st0ff3r/trappe/til ugespejl/still stoffer 9.jpg

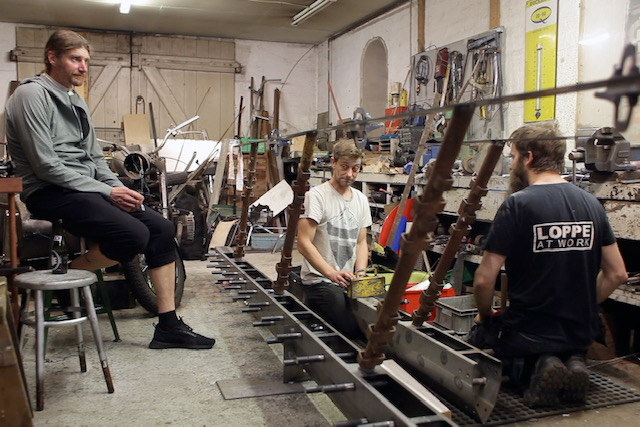
til ugespejl/still stoffer 9.jpg
