st0ff3r/trappe/til ugespejl/still stoffer 6.jpg

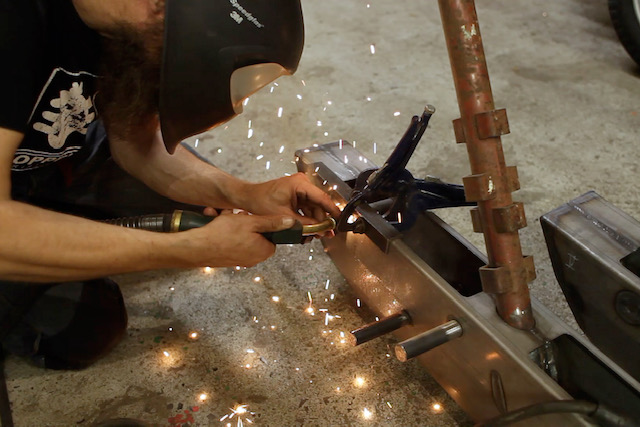
til ugespejl/still stoffer 6.jpg
