st0ff3r/trappe/skilt.rtf

Byggeår: 2020
Materiale: Stål, S355MC
Producent: stoffer@loppen.dk

https://github.com/st0ff3r/trappe

…skynd dig langsomt
