st0ff3r/trappe/projektoplæg.rtfd/TXT.rtf

Projektoplæg svendeprøve

1. Navn: Kristoffer Ek
2. Trappen er udviklet i samarbejde med Musikloppen.
3. Projektet er en trappe med have udført til Musikloppen. Vangerne fremstilles som rør med profil der giver plads til jord hvori der plantes efeu der vil gro op og dække rækværket udført i Ishøj-hegn. Dermed nyttiggøres vangerne til dobbelt formål. Innovativt idet der ikke findes lignende trapper. Den vil fremover tilføre en nødudgang et grønt miljø. Faktiske forhold er opmålt og tegninger fremstillede efter mål.
4. Skitsetegning
5. Sværhedsgradsskema
6. Svejseprocesser: 111, 141, 135/136
7. Trappen udføres i 3 mm stålplade til vanger, universal-stilladssøjler til balustre, håndfang af fladstål og trin af træ understøttet med rør der monteres i vangerne på stifter i vangerne. Vangernes ende udføres i 10 mm stål. Fødder ligeledes i 10 mm stål og gevindstang.
8. Maskiner og bearbejdsningsprocesser: CNC plasmaskæring, kantpresse, svejsning, savning, flammeskæring etc.
9. Stålforbrug
