st0ff3r/trappe/lasker.pdf

# lasker

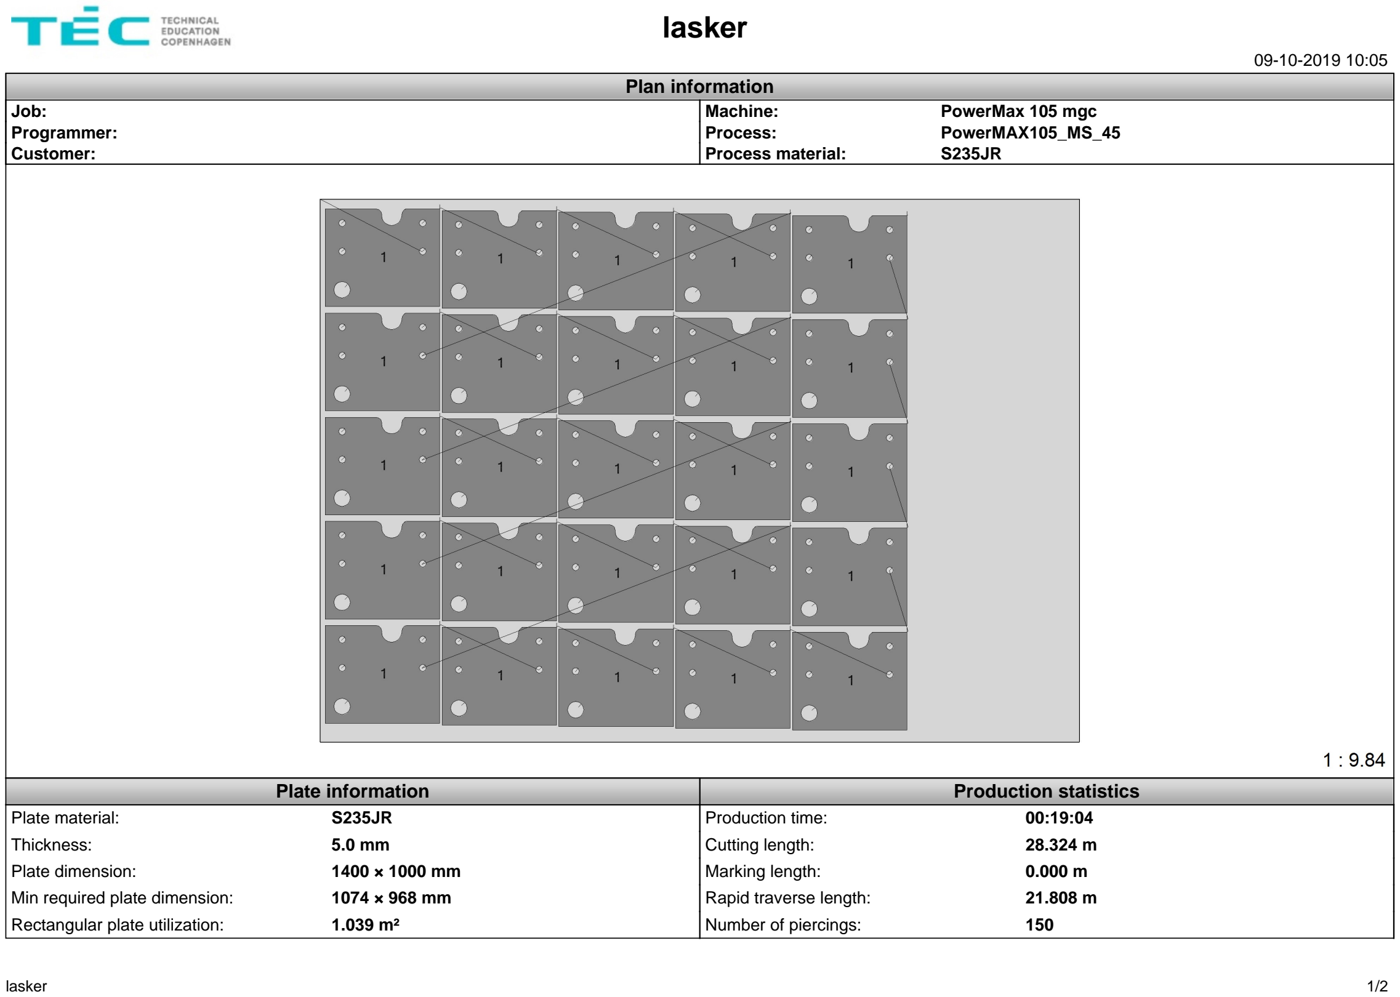
[picture p4: page 1]

09-10-2019 10:05
Plan information
Job: | Machine: | PowerMax 105 mgc
Programmer: | Process: | PowerMAX105_MS_45
Customer: | Process material: | S235JR
| Plate information | | Production statistics
Plate material: | S235JR | Production time: | 00:19:04
Thickness: | 5.0 mm | Cutting length: | 28.324 m
Plate dimension: | 1400 × 1000 mm | Marking length: | 0.000 m
Min required plate dimension: | 1074 × 968 mm | Rapid traverse length: | 21.808 m
Rectangular plate utilization: | 1.039 m² | Number of piercings: | 150
lasker | 1/2

Part ID | Part name | Quantity (nested) | Part size | Part weight | Cutting time
1 | laske | 25 | 211 × 180 mm | 1.403 kg | 00:00:43
lasker | 2/2
