st0ff3r/trappe/top- og bundvange-endeplader.pdf

# top- og bundvange-endeplader

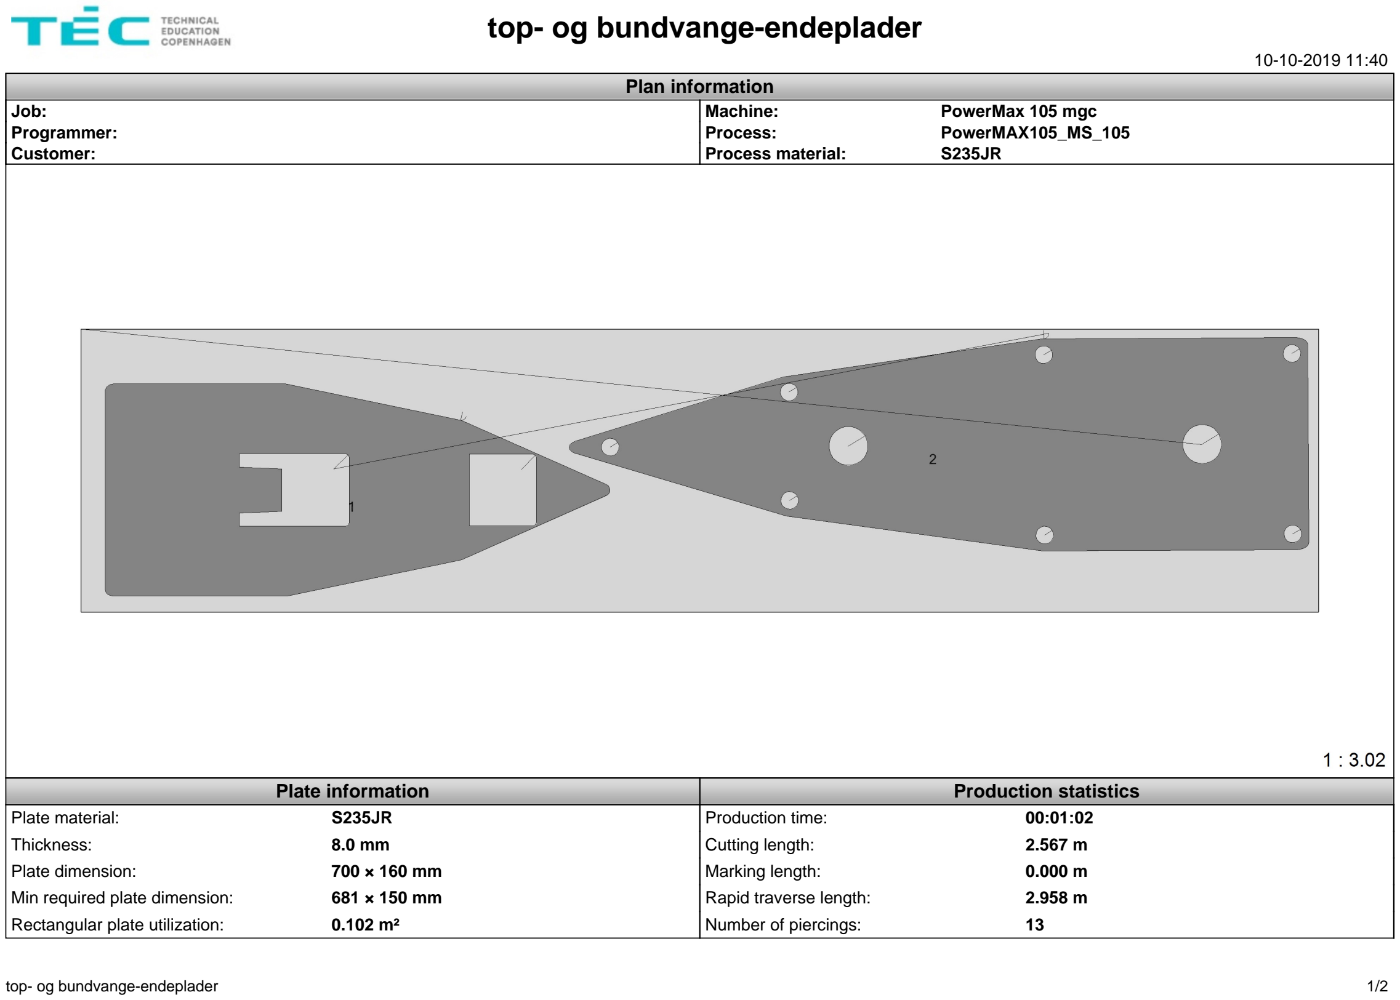
[picture p5: page 1]

10-10-2019 11:40
Plan information
Job: | Machine: | PowerMax 105 mgc
Programmer: | Process: | PowerMAX105_MS_105
Customer: | Process material: | S235JR
| Plate information | | Production statistics
Plate material: | S235JR | Production time: | 00:01:02
Thickness: | 8.0 mm | Cutting length: | 2.567 m
Plate dimension: | 700 × 160 mm | Marking length: | 0.000 m
Min required plate dimension: | 681 × 150 mm | Rapid traverse length: | 2.958 m
Rectangular plate utilization: | 0.102 m² | Number of piercings: | 13
top- og bundvange-endeplader | 1/2

Part ID | Part name | Quantity (nested) | Part size | Part weight | Cutting time
1 | top vange-endeplade | 1 | 120 × 285 mm | 1.391 kg | 00:00:25
2 | bund vange-endeplade | 1 | 422 × 139 mm | 2.277 kg | 00:00:30
top- og bundvange-endeplader | 2/2
