st0ff3r/trappe/vange 2.pdf

# vange 2

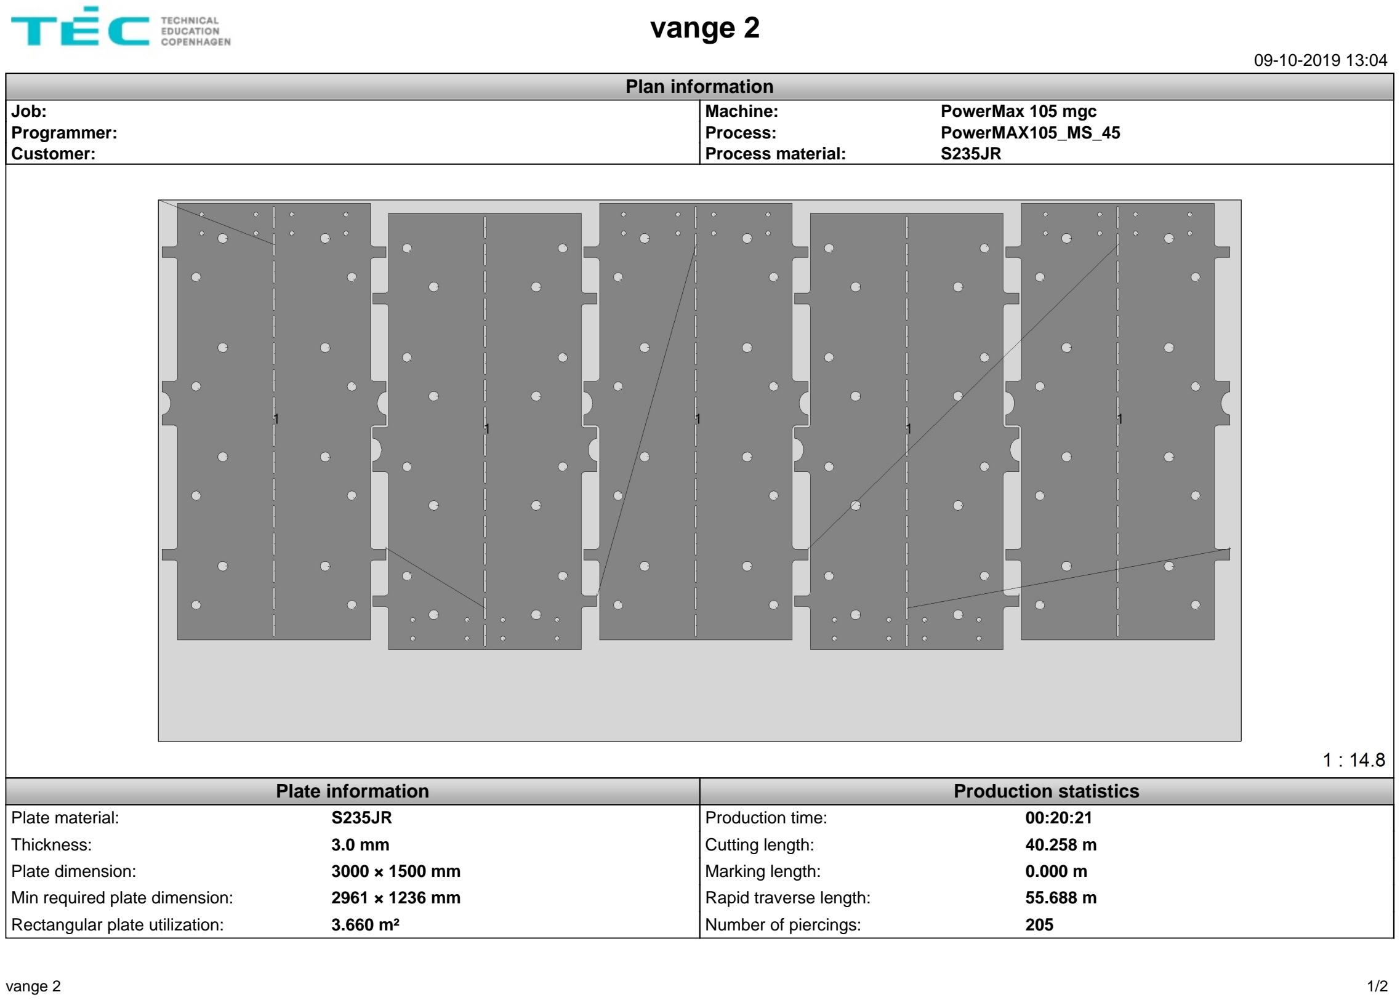
[picture p7: page 1]

09-10-2019 13:04
Plan information
Job: | Machine: | PowerMax 105 mgc
Programmer: | Process: | PowerMAX105_MS_45
Customer: | Process material: | S235JR
| Plate information | | Production statistics
Plate material: | S235JR | Production time: | 00:20:21
Thickness: | 3.0 mm | Cutting length: | 40.258 m
Plate dimension: | 3000 × 1500 mm | Marking length: | 0.000 m
Min required plate dimension: | 2961 × 1236 mm | Rapid traverse length: | 55.688 m
Rectangular plate utilization: | 3.660 m² | Number of piercings: | 205
vange 2 | 1/2

Part ID | Part name | Quantity (nested) | Part size | Part weight | Cutting time
1 | vange | 5 | 1209 × 621 mm | 15.156 kg | 00:03:50
vange 2 | 2/2
