st0ff3r/trappe/vange 3.pdf

# vange 3

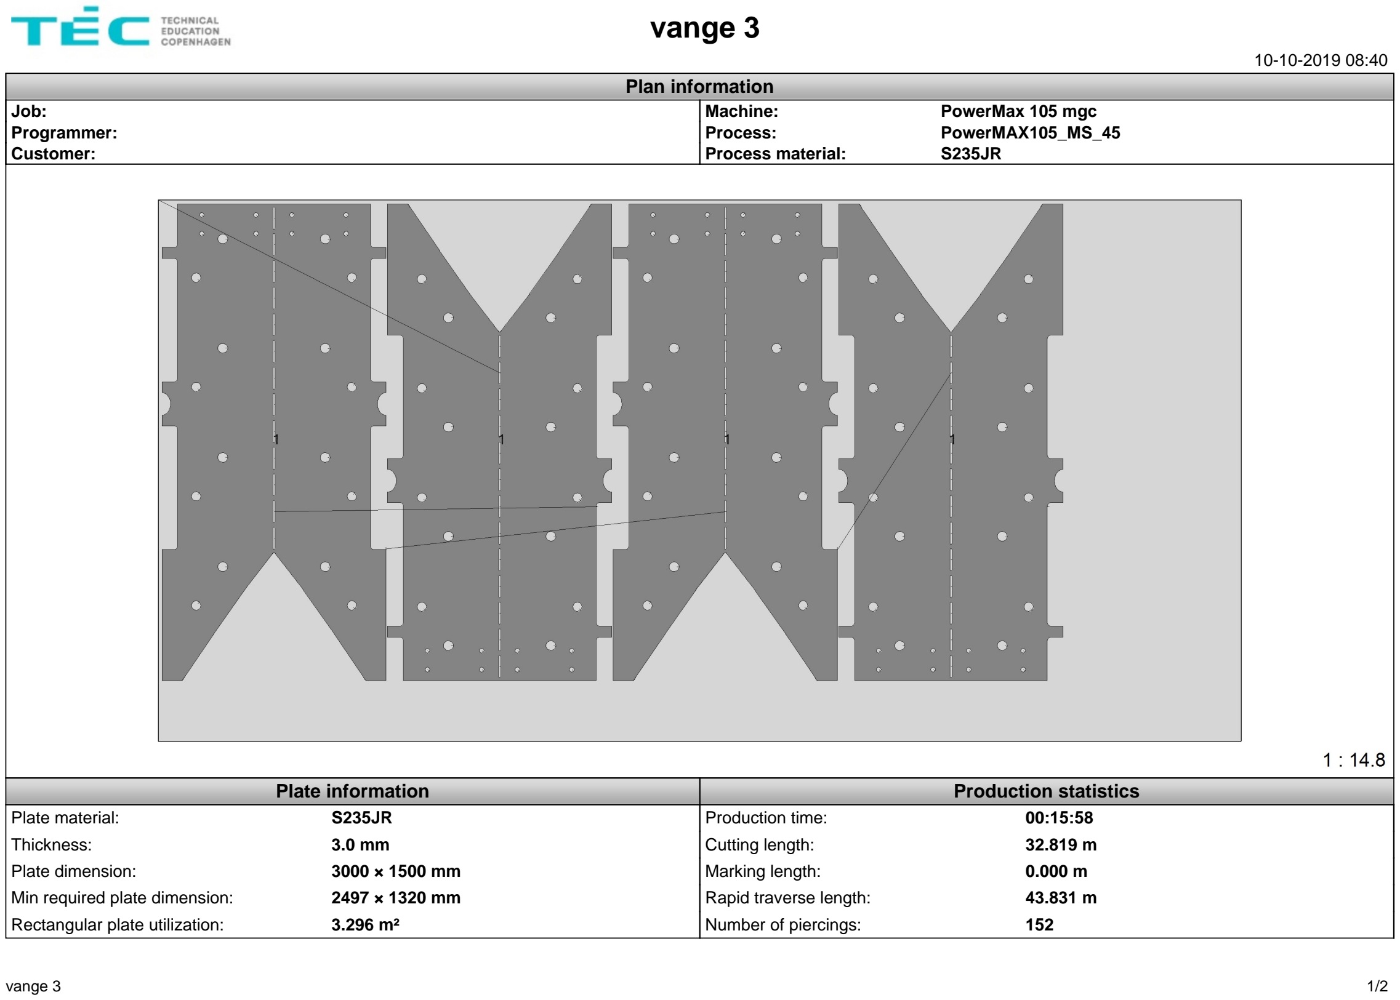
[picture p8: page 1]

10-10-2019 08:40
Plan information
Job: | Machine: | PowerMax 105 mgc
Programmer: | Process: | PowerMAX105_MS_45
Customer: | Process material: | S235JR
| Plate information | | Production statistics
Plate material: | S235JR | Production time: | 00:15:58
Thickness: | 3.0 mm | Cutting length: | 32.819 m
Plate dimension: | 3000 × 1500 mm | Marking length: | 0.000 m
Min required plate dimension: | 2497 × 1320 mm | Rapid traverse length: | 43.831 m
Rectangular plate utilization: | 3.296 m² | Number of piercings: | 152
vange 3 | 1/2

Part ID | Part name | Quantity (nested) | Part size | Part weight | Cutting time
1 | vange bund | 4 | 1320 × 621 mm | 15.068 kg | 00:03:46
vange 3 | 2/2
