st0ff3r/trappe/vanger 2.pdf

# vanger 2

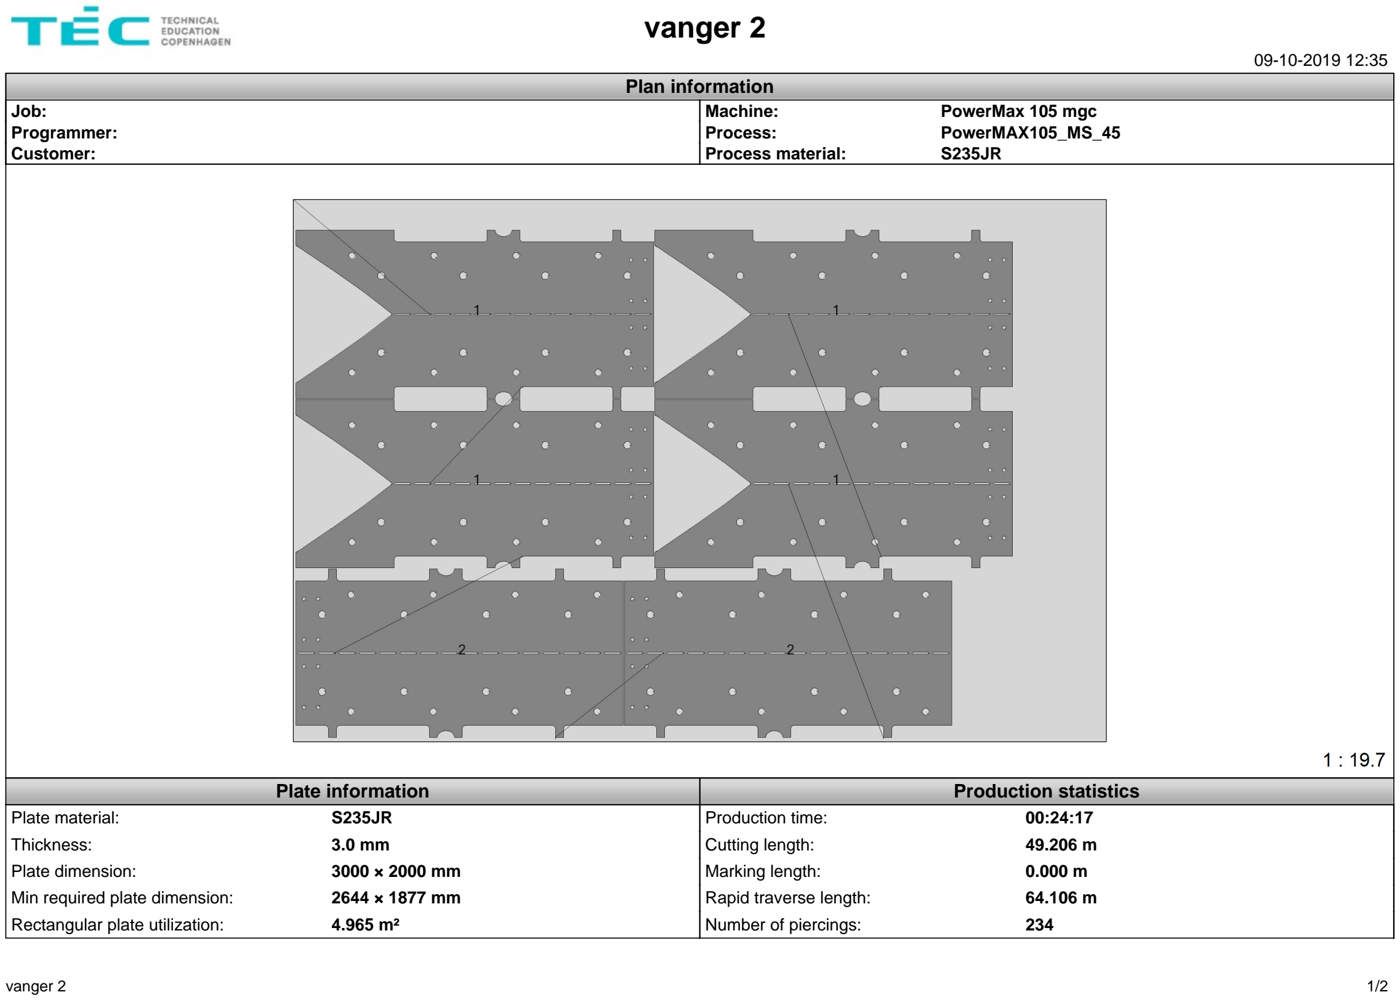
[picture p11: page 1]

09-10-2019 12:35
Plan information
Job: | Machine: | PowerMax 105 mgc
Programmer: | Process: | PowerMAX105_MS_45
Customer: | Process material: | S235JR
| Plate information | | Production statistics
Plate material: | S235JR | Production time: | 00:24:17
Thickness: | 3.0 mm | Cutting length: | 49.206 m
Plate dimension: | 3000 × 2000 mm | Marking length: | 0.000 m
Min required plate dimension: | 2644 × 1877 mm | Rapid traverse length: | 64.106 m
Rectangular plate utilization: | 4.965 m² | Number of piercings: | 234
vanger 2 | 1/2

Part ID | Part name | Quantity (nested) | Part size | Part weight | Cutting time
1 | vange bund | 4 | 1320 × 621 mm | 15.068 kg | 00:03:48
2 | vange | 2 | 1209 × 621 mm | 15.156 kg | 00:03:52
vanger 2 | 2/2
