st0ff3r/trappe/svejselære/svejselære 1.pdf

# svejselære 1

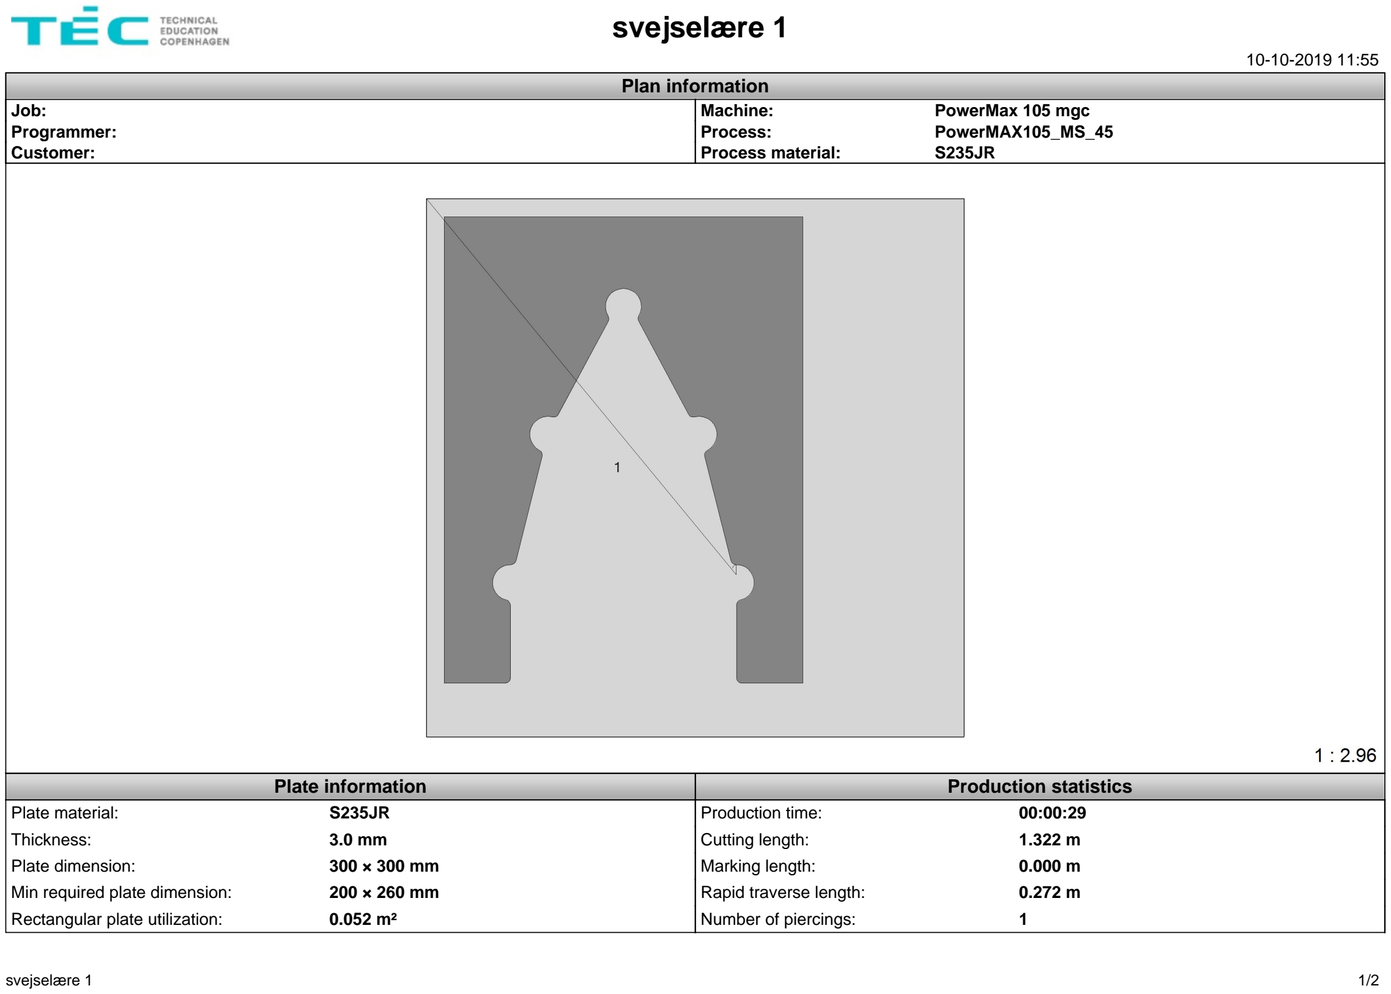
[picture p13: page 1]

10-10-2019 11:55
Plan information
Job: | Machine: | PowerMax 105 mgc
Programmer: | Process: | PowerMAX105_MS_45
Customer: | Process material: | S235JR
| Plate information | | Production statistics
Plate material: | S235JR | Production time: | 00:00:29
Thickness: | 3.0 mm | Cutting length: | 1.322 m
Plate dimension: | 300 × 300 mm | Marking length: | 0.000 m
Min required plate dimension: | 200 × 260 mm | Rapid traverse length: | 0.272 m
Rectangular plate utilization: | 0.052 m² | Number of piercings: | 1
svejselære 1 | 1/2

Part ID | Part name | Quantity (nested) | Part size | Part weight | Cutting time
1 | svejselære 1 | 1 | 260 × 200 mm | 0.755 kg | 00:00:29
svejselære 1 | 2/2
