st0ff3r/trappe/svejselære/svejselære 2 del 1.pdf

# svejselære 2 del 1

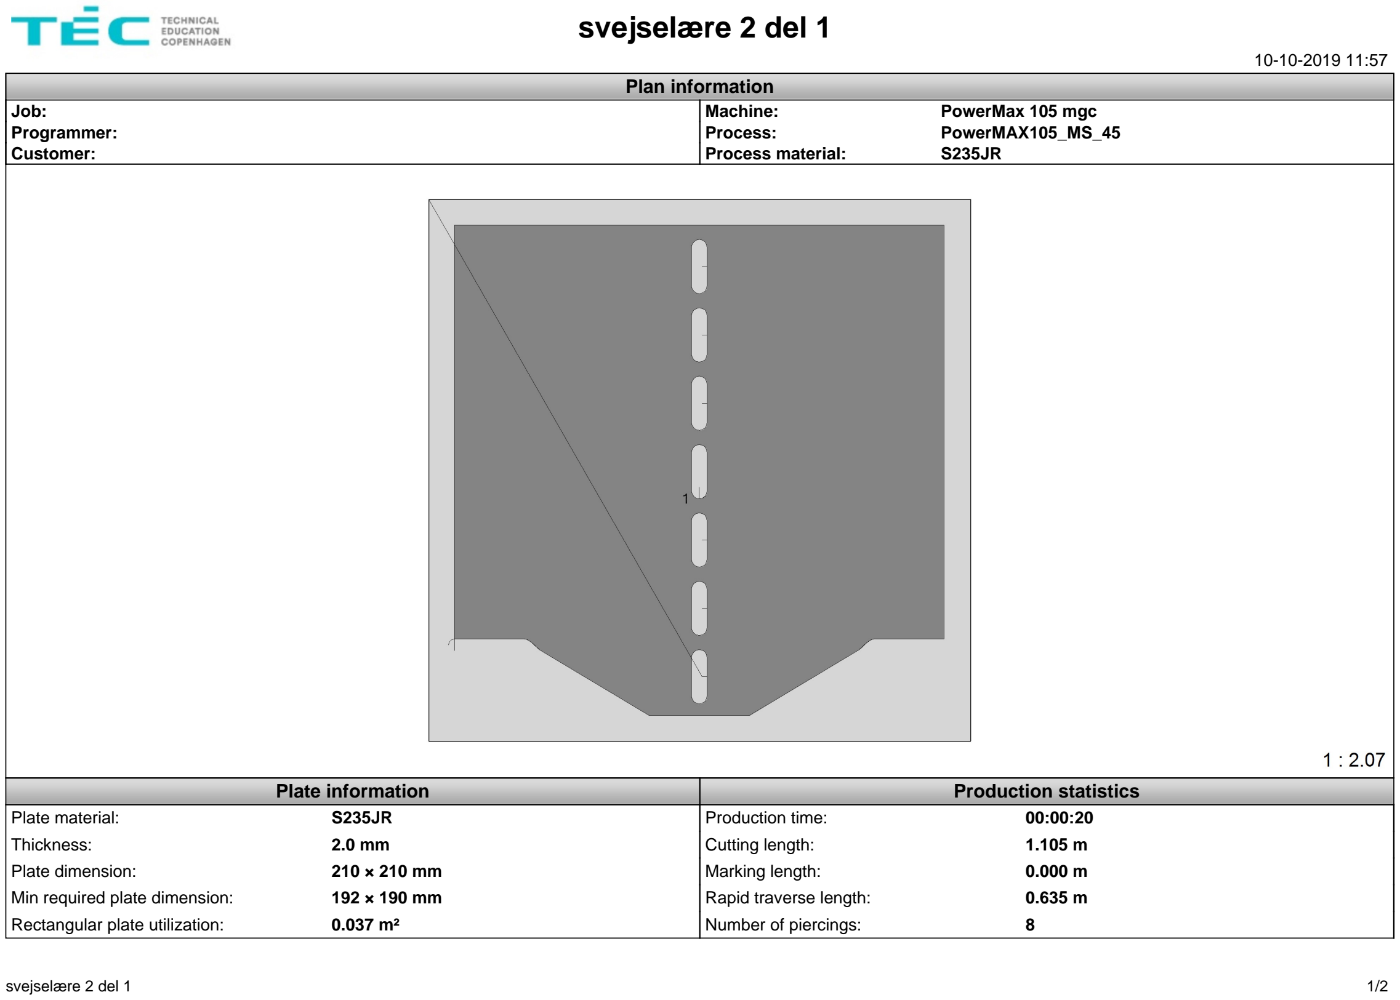
[picture p14: page 1]

10-10-2019 11:57
Plan information
Job: | Machine: | PowerMax 105 mgc
Programmer: | Process: | PowerMAX105_MS_45
Customer: | Process material: | S235JR
| Plate information | | Production statistics
Plate material: | S235JR | Production time: | 00:00:20
Thickness: | 2.0 mm | Cutting length: | 1.105 m
Plate dimension: | 210 × 210 mm | Marking length: | 0.000 m
Min required plate dimension: | 192 × 190 mm | Rapid traverse length: | 0.635 m
Rectangular plate utilization: | 0.037 m² | Number of piercings: | 8
svejselære 2 del 1 | 1/2

Part ID | Part name | Quantity (nested) | Part size | Part weight | Cutting time
1 | svejselære 2 del 1 | 1 | 190 × 190 mm | 0.506 kg | 00:00:18
svejselære 2 del 1 | 2/2
