st0ff3r/trappe/svejselære/svejselære 2 del 2.pdf

# svejselære 2 del 2

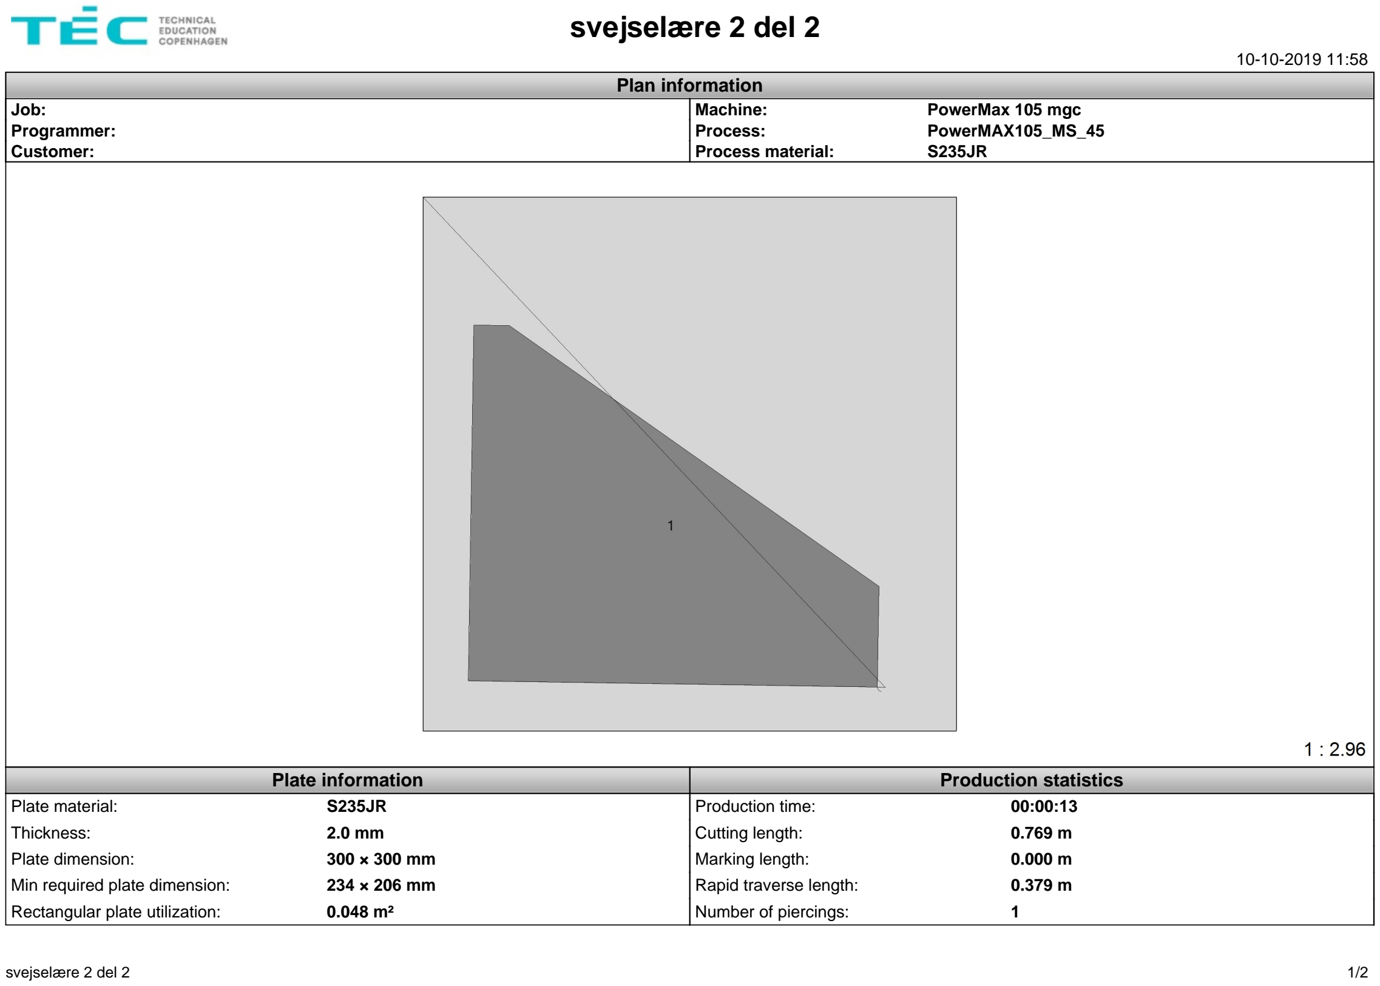
[picture p15: page 1]

10-10-2019 11:58
Plan information
Job: | Machine: | PowerMax 105 mgc
Programmer: | Process: | PowerMAX105_MS_45
Customer: | Process material: | S235JR
| Plate information | | Production statistics
Plate material: | S235JR | Production time: | 00:00:13
Thickness: | 2.0 mm | Cutting length: | 0.769 m
Plate dimension: | 300 × 300 mm | Marking length: | 0.000 m
Min required plate dimension: | 234 × 206 mm | Rapid traverse length: | 0.379 m
Rectangular plate utilization: | 0.048 m² | Number of piercings: | 1
svejselære 2 del 2 | 1/2

Part ID | Part name | Quantity (nested) | Part size | Part weight | Cutting time
1 | svejselære 2 del 2 | 1 | 303 × 176 mm | 0.486 kg | 00:00:12
svejselære 2 del 2 | 2/2
