st0ff3r/trappe/Rapport - konklusion.rtf

Svendeprøve konklusion
Som smed på Christiania er opgaverne meget forskellige og løsningerne bliver sjældent serieproduceret, derfor gar det været spændende at fabrikere en hel trappe i moduler. En stor del af opgaven var i første opgang at opmåle de eksisterende forhold og tilpasse trappen disse. Op til og i begyndelsen af værkstedsperioden har jeg løbende fabrikeret prototyper på kritiske detaljer og taget dem med til Christiania og afprøvet.

Undervejs på værkstedet opdagede jeg naturligvis småfejl i tegningerne som manglende dimensioner eller uhensigtsmæssige svejsninger. Vedlagt er nyeste version af tegninger.

Jeg vil gerne benytte lejligheden til at takke alle der i forløbet har deltaget med uvurderlige tanker og idéer.
