st0ff3r/trappe/modul.pdf

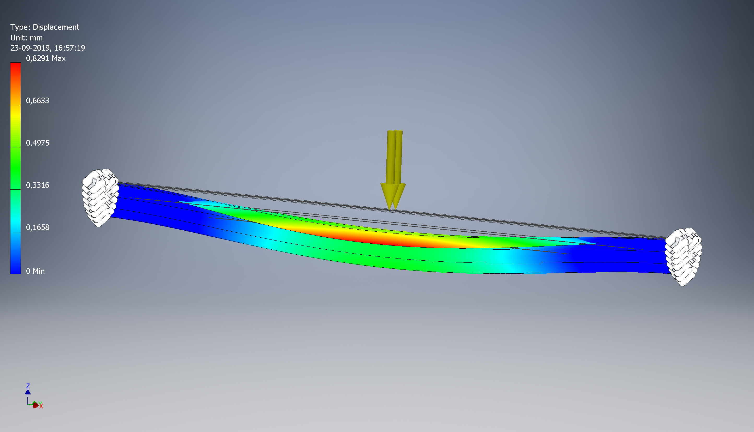
[picture p17: page 1]
