st0ff3r/trappe/til ugespejl/still stoffer5.jpg

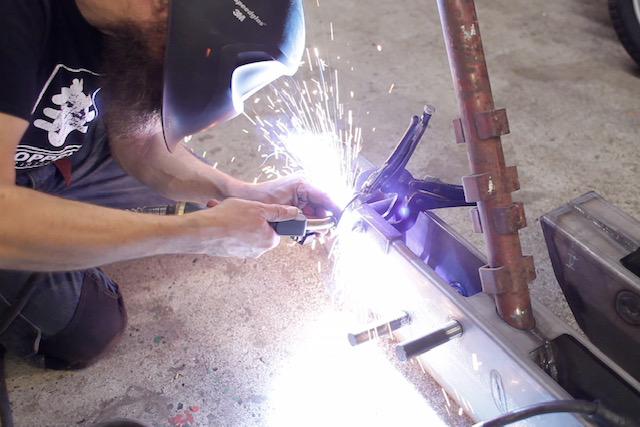
til ugespejl/still stoffer5.jpg
