st0ff3r/trappe/til ugespejl/still stoffer 2.jpg

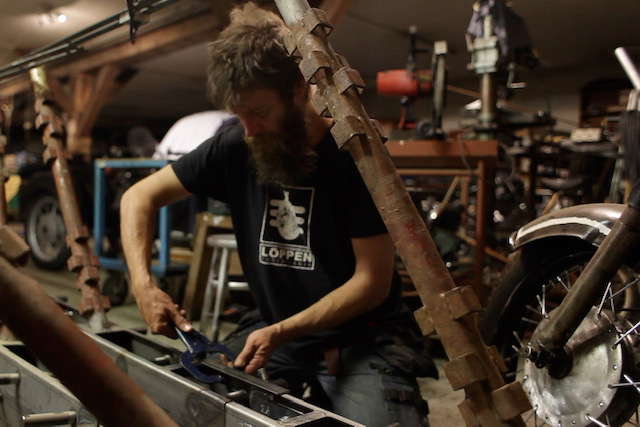
til ugespejl/still stoffer 2.jpg
