st0ff3r/trappe/til ugespejl/still stoffer 3.jpg

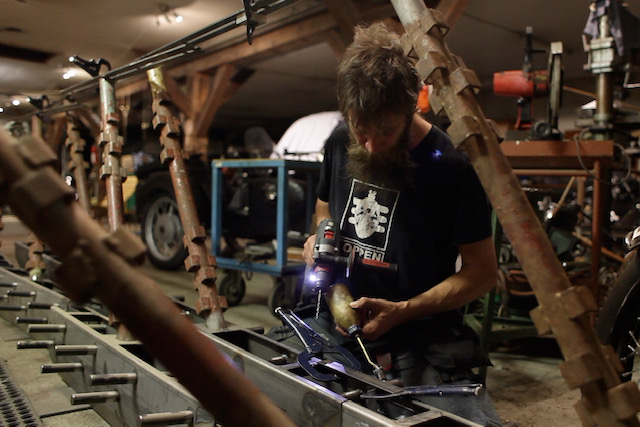
til ugespejl/still stoffer 3.jpg
