st0ff3r/trappe/til ugespejl/still stoffer 4.jpg

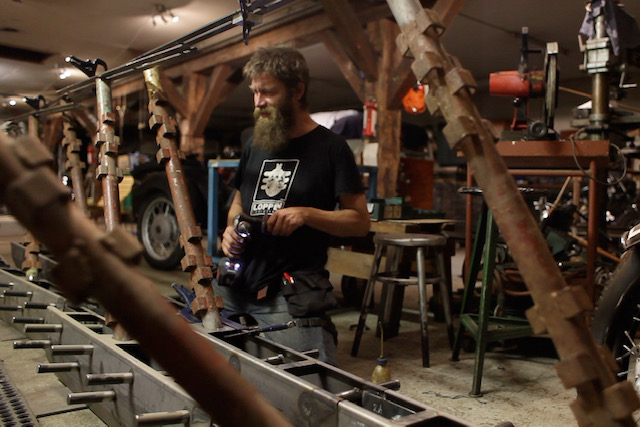
til ugespejl/still stoffer 4.jpg
