st0ff3r/trappe/til ugespejl/still stoffer 8.jpg

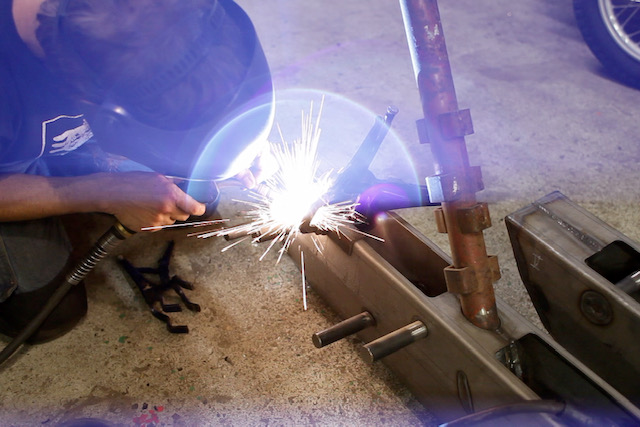
til ugespejl/still stoffer 8.jpg
