st0ff3r/trappe/til ugespejl/still stoffer 10.jpg

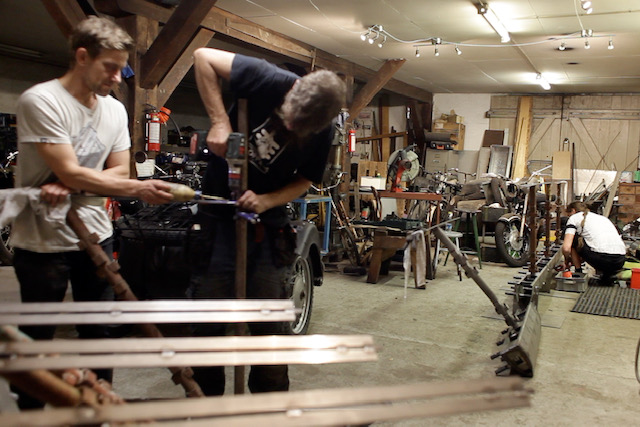
til ugespejl/still stoffer 10.jpg
