st0ff3r/trappe/til ugespejl/still stoffer 11.jpg

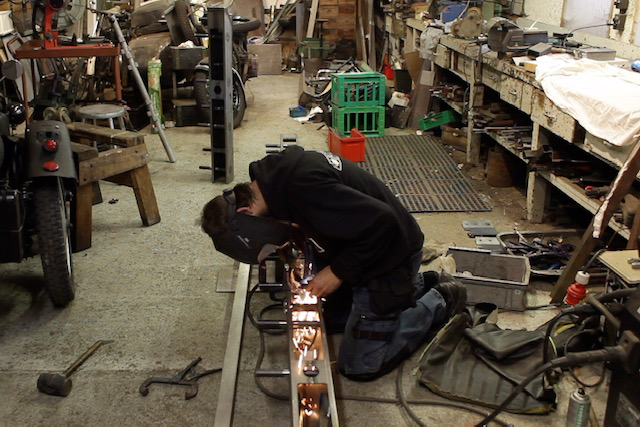
til ugespejl/still stoffer 11.jpg
