st0ff3r/trappe/potteplanteholder/hage.dxf

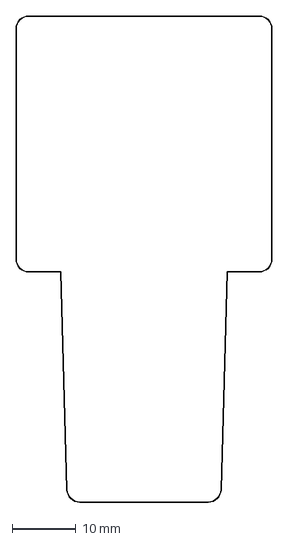
[picture p25: CAD file, 2020-08-13]
potteplanteholder/hage.dxf
40.0 x 76.0 mm
