st0ff3r/trappe/svejselære/svejselære 3.dxf

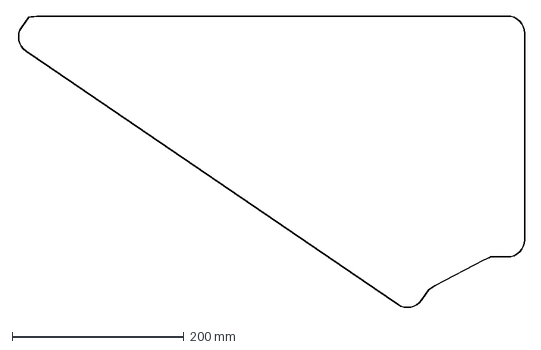
[picture p26: CAD file, 2020-08-13]
svejselære/svejselære 3.dxf
591.4 x 341.6 mm
