st0ff3r/trappe/laske rettet hulplacering.dxf

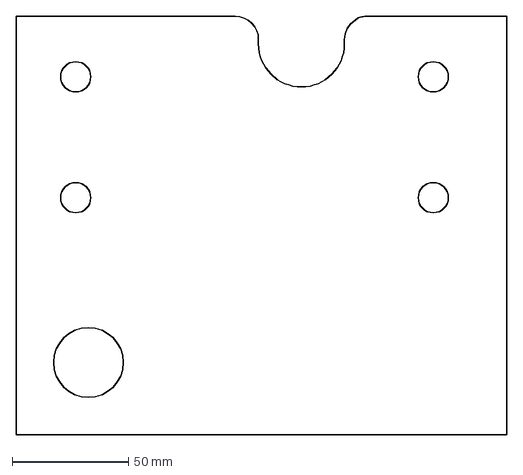
[picture p27: CAD file, 2020-08-13]
laske rettet hulplacering.dxf
211.0 x 180.0 mm
