st0ff3r/trappe/svejselære/svejselære 1.dxf

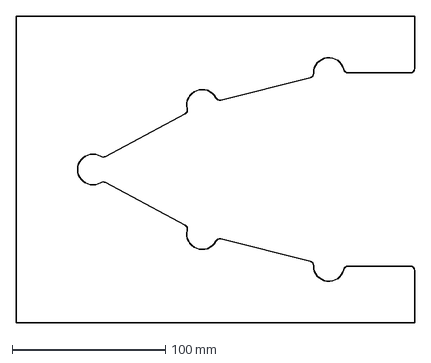
[picture p28: CAD file, 2020-08-13]
svejselære/svejselære 1.dxf
260.0 x 200.0 mm
