st0ff3r/trappe/svejselære/svejselære 2 del 1.dxf

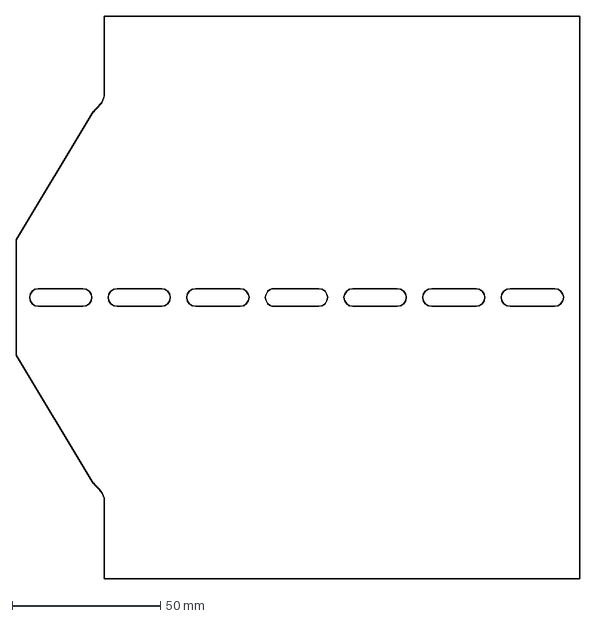
[picture p29: CAD file, 2020-08-13]
svejselære/svejselære 2 del 1.dxf
190.0 x 189.7 mm
