st0ff3r/trappe/vange top.dxf

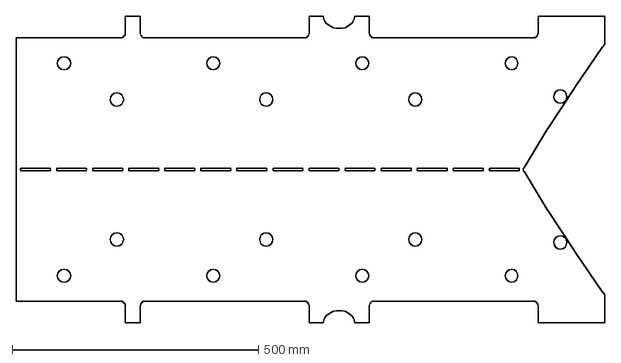
[picture p30: CAD file, 2020-08-13]
vange top.dxf
1193.8 x 621.0 mm
