st0ff3r/trappe/svejselære/svejselære 2 del 2.dxf

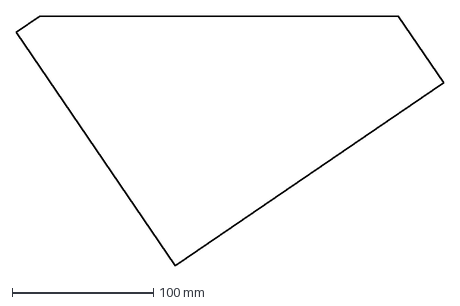
[picture p31: CAD file, 2020-08-13]
svejselære/svejselære 2 del 2.dxf
302.7 x 176.5 mm
