st0ff3r/trappe/top vange-endeplade.dxf

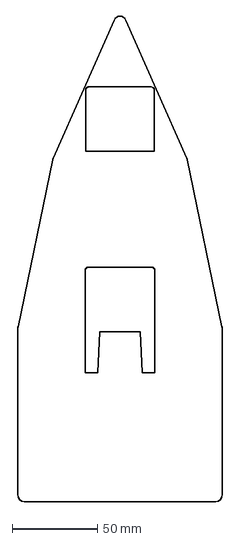
[picture p32: CAD file, 2020-08-13]
top vange-endeplade.dxf
120.0 x 285.5 mm
