st0ff3r/trappe/plade.dxf

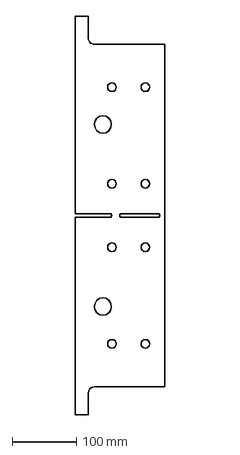
[picture p33: CAD file, 2020-08-13]
plade.dxf
140.0 x 621.0 mm
