st0ff3r/trappe/skot.dxf

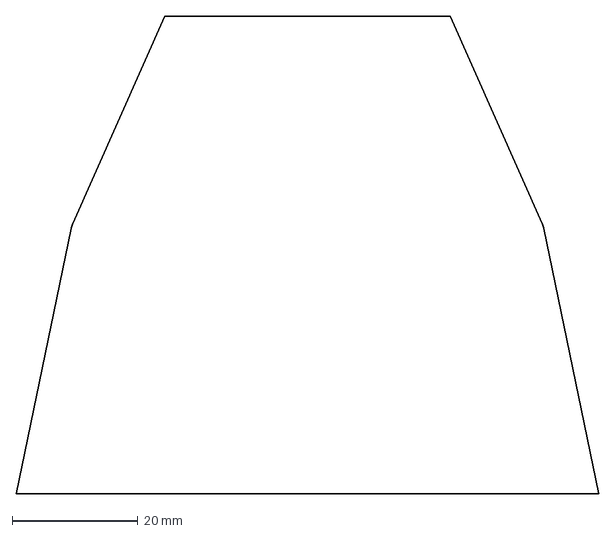
[picture p34: CAD file, 2020-08-13]
skot.dxf
92.7 x 76.0 mm
