st0ff3r/trappe/vange.dxf

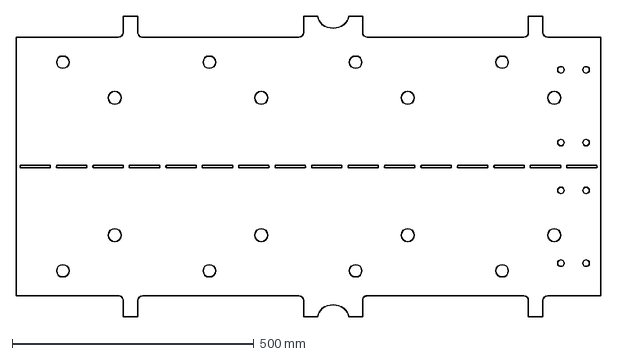
[picture p35: CAD file, 2020-08-13]
vange.dxf
1208.9 x 621.0 mm
