st0ff3r/trappe/bund vange-endeplade.dxf

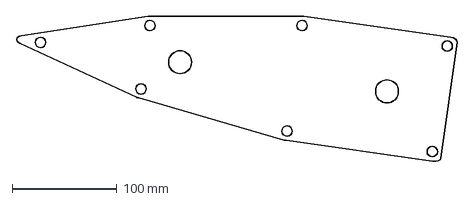
[picture p36: CAD file, 2020-08-13]
bund vange-endeplade.dxf
422.2 x 139.4 mm
