st0ff3r/trappe/vange bund.dxf

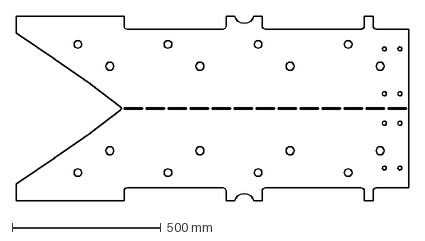
[picture p37: CAD file, 2020-08-13]
vange bund.dxf
1320.0 x 621.0 mm
