st0ff3r/trappe/skot opad.dxf

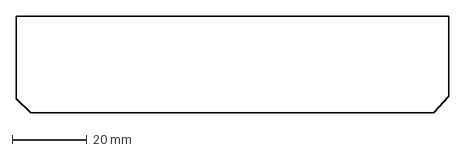
[picture p38: CAD file, 2020-08-13]
skot opad.dxf
116.0 x 26.0 mm
