st0ff3r/trappe/baluster-fod.dxf

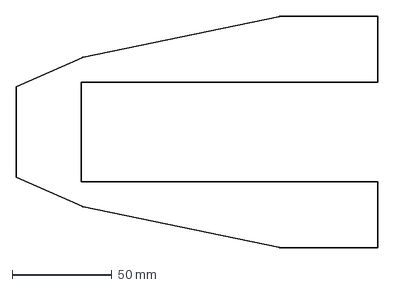
[picture p39: CAD file, 2020-08-13]
baluster-fod.dxf
181.4 x 116.0 mm
