st0ff3r/trappe/plade top test.dxf

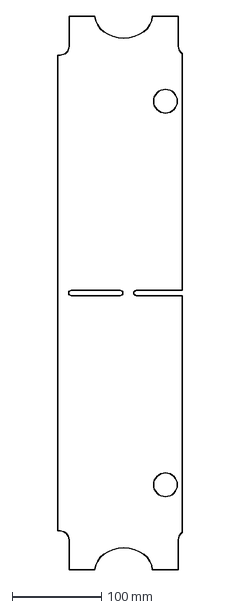
[picture p40: CAD file, 2020-08-13]
plade top test.dxf
140.0 x 620.8 mm
