st0ff3r/trappe/laske.dxf

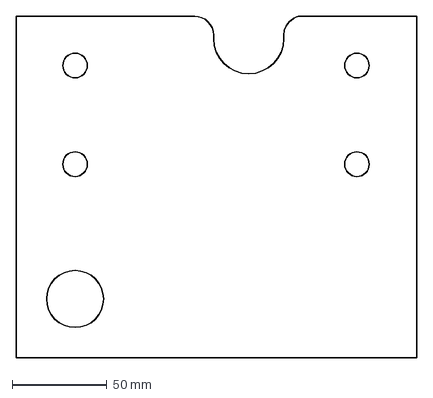
[picture p41: CAD file, 2020-08-13]
laske.dxf
211.0 x 180.0 mm
