st0ff3r/trappe/plade laskehuller test.dxf

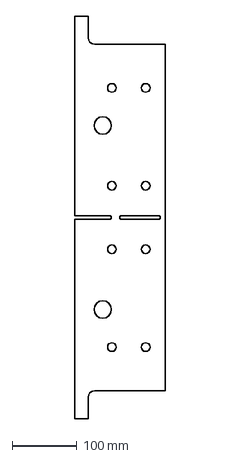
[picture p42: CAD file, 2020-08-13]
plade laskehuller test.dxf
140.0 x 620.8 mm
