st0ff3r/trappe/(list of files, cad)

Other CAD files:
modul med balustre til dot.dk.dwg
OldVersions/baluster-fod.0026.ipt
OldVersions/bund vange-endeplade.0007.ipt
OldVersions/laske rettet hulplacering.0004.ipt
OldVersions/laske spejlet.0032.ipt
OldVersions/laske.0039.ipt
OldVersions/model.0014.ipt
OldVersions/modul bund.0015.ipn
OldVersions/modul bund.0164.iam
OldVersions/modul top.0027.ipn
OldVersions/modul top.0146.iam
OldVersions/modul.0021.ipn
OldVersions/modul.0187.iam
OldVersions/mål.0003.ipt
OldVersions/mål.0011.idw
OldVersions/ny top vange-endeplade.0035.ipt
OldVersions/plade bund.0068.ipt
OldVersions/plade bund.0069.ipt
OldVersions/plade top.0076.ipt
OldVersions/plade top.0077.ipt
OldVersions/plade.0072.ipt
OldVersions/plade.0073.ipt
OldVersions/skot opad smal.0007.ipt
OldVersions/skot opad.0013.ipt
OldVersions/skot.0013.ipt
OldVersions/stigning.0001.ipt
OldVersions/søjle+top.0033.iam
OldVersions/søjle+vange.0043.ipn
OldVersions/søjle+vange.0249.iam
OldVersions/top vange-endeplade.0036.ipt
OldVersions/trappe 2.0191.idw
OldVersions/trappestift skrå.0038.ipt
OldVersions/trappestift.0034.ipt
OldVersions/trin-rør.0001.ipt
OldVersions/tværplade opad smal.0010.ipt
OldVersions/tværplade opad smal.0011.ipt
OldVersions/tværplade opad.0007.ipt
OldVersions/tværplade opad.0008.ipt
OldVersions/tværplade.0003.ipt
OldVersions/tværplade.0004.ipt
OldVersions/vange bund.0015.ipt
OldVersions/vange med trin.0004.iam
OldVersions/vange top.0014.ipt
OldVersions/vange.0018.ipt
baluster-fod.ipt
baluster/OldVersions/rør.0031.ipt
baluster/OldVersions/stilladssøjle.0044.iam
baluster/OldVersions/søjle.0001.iam
baluster/OldVersions/øre.0011.ipt
baluster/rør.ipt
baluster/stilladssøjle.iam
baluster/øre.ipt
bund vange-endeplade.ipt
hegn/OldVersions/bue.0004.ipt
hegn/OldVersions/bukket del.0006.ipt
hegn/OldVersions/gevindmuffe.0001.ipt
hegn/OldVersions/hage.0006.ipt
hegn/OldVersions/hegnspæl omvendt.0030.iam
hegn/OldVersions/hegnspæl omvendt.0030_1.iam
hegn/OldVersions/hegnspæl, oppe, top.0018.iam
hegn/OldVersions/hegnspæl, oppe, top.0018_1.iam
hegn/OldVersions/hegnspæl.0039.iam
hegn/OldVersions/hegnspæl.0039_1.iam
hegn/OldVersions/t-profil.0002.iam
hegn/OldVersions/t-profil.0002.ipt
hegn/bue.ipt
hegn/bukket del.ipt
hegn/gevindmuffe.ipt
hegn/hage.ipt
hegn/hegnspæl omvendt.iam
hegn/hegnspæl, oppe, top.iam
hegn/hegnspæl.iam
hegn/t-profil.ipt
hegn/t-profil/Frame/DIN T30 00000001.ipt
hegn/t-profil/Frame/Frame0002.iam
hegn/t-profil/Frame/OldVersions/DIN T30 00000001.0003.ipt
hegn/t-profil/Frame/OldVersions/Frame0002.0005.iam
hegn/t-profil/Frame/OldVersions/Skeleton0002.0002.ipt
hegn/t-profil/Frame/Skeleton0002.ipt
håndfang/OldVersions/acryl-difuseringsplader.0002.ipt
håndfang/OldVersions/afstandsstykke kort.0013.ipt
håndfang/OldVersions/afstandsstykke.0009.ipt
håndfang/OldVersions/håndfang bund.0019.iam
håndfang/OldVersions/håndfang snit.0010.iam
håndfang/OldVersions/håndfang.0003.ipt
håndfang/OldVersions/håndfang.0022.iam
håndfang/OldVersions/led-liste.0003.ipt
håndfang/OldVersions/stang.0008.ipt
håndfang/OldVersions/stang.0009.ipt
håndfang/OldVersions/træhåndfang.0045.ipt
håndfang/acryl-difuseringsplader.ipt
håndfang/afstandsstykke kort.ipt
håndfang/afstandsstykke.ipt
håndfang/håndfang bund.iam
håndfang/håndfang snit.iam
håndfang/håndfang.iam
håndfang/håndfang.ipt
håndfang/led-liste.ipt
håndfang/træhåndfang.ipt
laske rettet hulplacering.ipt
laske spejlet.ipt
laske.ipt
model.ipt
modul bund.iam
modul bund.ipn
modul top.iam
modul top.ipn
modul.iam
modul.ipn
mål.idw
mål.ipt
placering af top vange-endeplade på stillads.iam
potteplanteholder/OldVersions/armeringsjern.0002.ipt
potteplanteholder/OldVersions/hage.0003.ipt
potteplanteholder/OldVersions/potteplanteholder.0004.iam
potteplanteholder/OldVersions/valset ring.0005.ipt
potteplanteholder/armeringsjern.ipt
potteplanteholder/hage.ipt
potteplanteholder/potteplanteholder.iam
potteplanteholder/valset ring.ipt
skot opad smal.ipt
skot opad.ipt
skot.ipt
stigning.ipt
svejselære/OldVersions/svejselære 1.0002.ipt
svejselære/OldVersions/svejselære 2 del 1.0004.ipt
svejselære/OldVersions/svejselære 2 del 2.0004.ipt
svejselære/OldVersions/svejselære 2 del 2xxx.0001.ipt
svejselære/OldVersions/svejselære 3.0006.ipt
svejselære/OldVersions/svejselære.0004.iam
svejselære/svejselære 1.ipt
svejselære/svejselære 2 del 1.ipt
svejselære/svejselære 2 del 2.ipt
svejselære/svejselære 3.ipt
svejselære/svejselære.iam
søjle+vange.iam
søjle+vange.ipn
søjle+vange/Design Accelerator/Bolted Connection1.iam
søjle+vange/Design Accelerator/Bolted Connection10.iam
søjle+vange/Design Accelerator/Bolted Connection11.iam
søjle+vange/Design Accelerator/Bolted Connection12.iam
søjle+vange/Design Accelerator/Bolted Connection13.iam
søjle+vange/Design Accelerator/Bolted Connection14.iam
søjle+vange/Design Accelerator/Bolted Connection15.iam
søjle+vange/Design Accelerator/Bolted Connection16.iam
søjle+vange/Design Accelerator/Bolted Connection17.iam
søjle+vange/Design Accelerator/Bolted Connection18.iam
søjle+vange/Design Accelerator/Bolted Connection19.iam
søjle+vange/Design Accelerator/Bolted Connection2.iam
søjle+vange/Design Accelerator/Bolted Connection20.iam
søjle+vange/Design Accelerator/Bolted Connection21.iam
søjle+vange/Design Accelerator/Bolted Connection22.iam
søjle+vange/Design Accelerator/Bolted Connection23.iam
søjle+vange/Design Accelerator/Bolted Connection24.iam
søjle+vange/Design Accelerator/Bolted Connection3.iam
søjle+vange/Design Accelerator/Bolted Connection4.iam
søjle+vange/Design Accelerator/Bolted Connection5.iam
søjle+vange/Design Accelerator/Bolted Connection6.iam
søjle+vange/Design Accelerator/Bolted Connection7.iam
søjle+vange/Design Accelerator/Bolted Connection8.iam
søjle+vange/Design Accelerator/Bolted Connection9.iam
søjle/OldVersions/rør.0012.ipt
søjle/OldVersions/stilladssøjle.0023.iam
søjle/OldVersions/søjle.0001.iam
søjle/OldVersions/øre.0011.ipt
søjle/rør.ipt
søjle/stilladssøjle.iam
søjle/øre.ipt
top vange-endeplade.ipt
trappe old.idw
trappe.idw
trappestift skrå.ipt
trappestift.ipt
trin/OldVersions/liste.0002.ipt
trin/OldVersions/trin-rør.0004.ipt
trin/OldVersions/trin-top.0004.iam
trin/OldVersions/trin-top.0007.iam
trin/OldVersions/trin.0012.iam
trin/OldVersions/trin.0013.iam
trin/OldVersions/trinbrædt.0006.ipt
trin/liste.ipt
trin/trin-rør.ipt
trin/trin-top.iam
trin/trin.iam
trin/trinbrædt-justering.ipt
trin/trinbrædt.ipt
vange bund.ipt
vange med trin.iam
vange top.ipt
vange.ipt
