st0ff3r/trappe/trappe.pdf

# Beplantet bæredygtig trappe

## Svendeprøve 2019

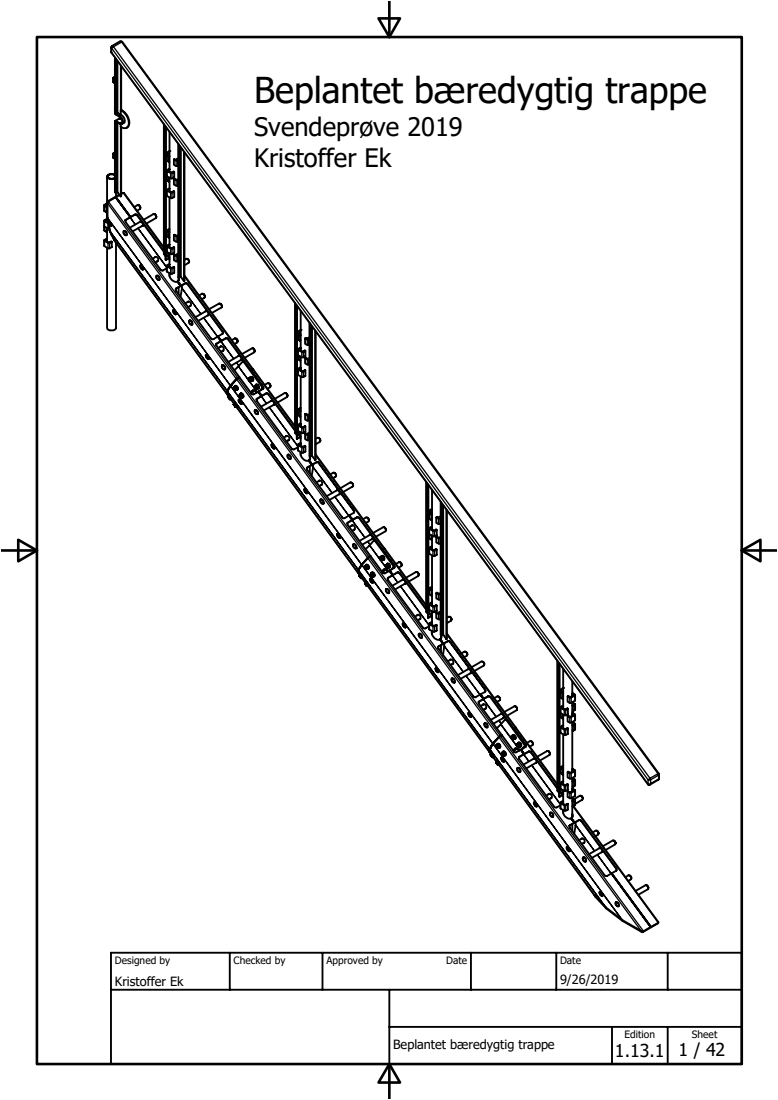
[picture p43: page 1]
Kristoffer Ek; Designed by; Checked by; Approved by; Date; Edition; Sheet

Beplantet bæredygtig trappe

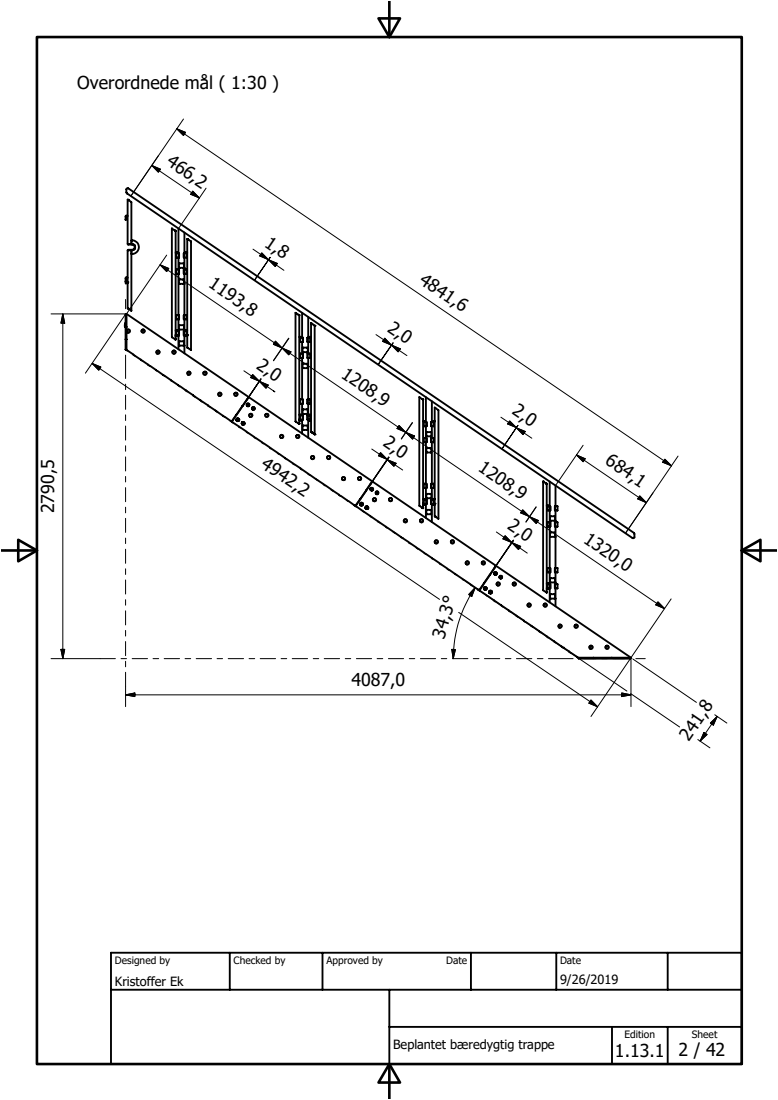
[picture p44: page 2]
Overordnede mål ( 1:30 ); Kristoffer Ek; Designed by; Checked by; Approved by; Date

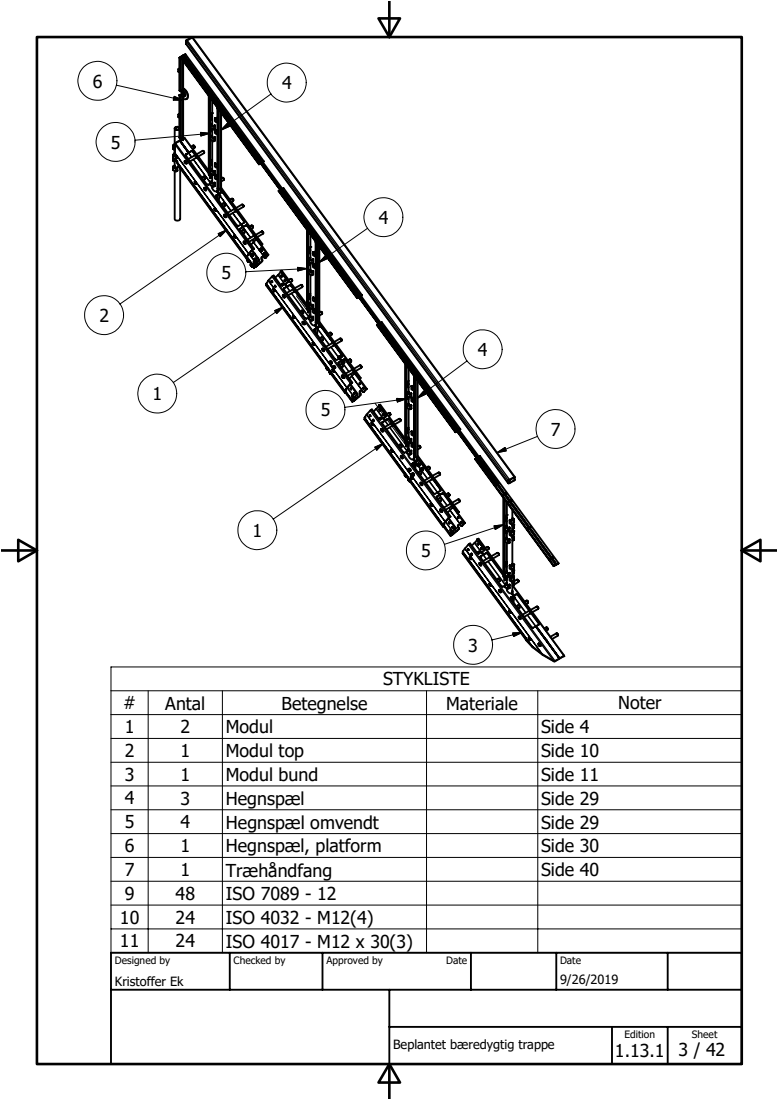
[picture p45: page 3]
Kristoffer Ek; Designed by; Checked by; Approved by; Date; STYKLISTE; Antal; Betegnelse; Materiale; Noter; Modul; Side 4; Modul top; Side 10; Modul bund; Side 11; Hegnspæl; Side 29; Hegnspæl omvendt; Hegnspæl, platform; Side 30; Træhåndfang; Side 40; ISO 7089 - 12; ISO 4032 - M12(4); ISO 4017 - M12 x 30(3)

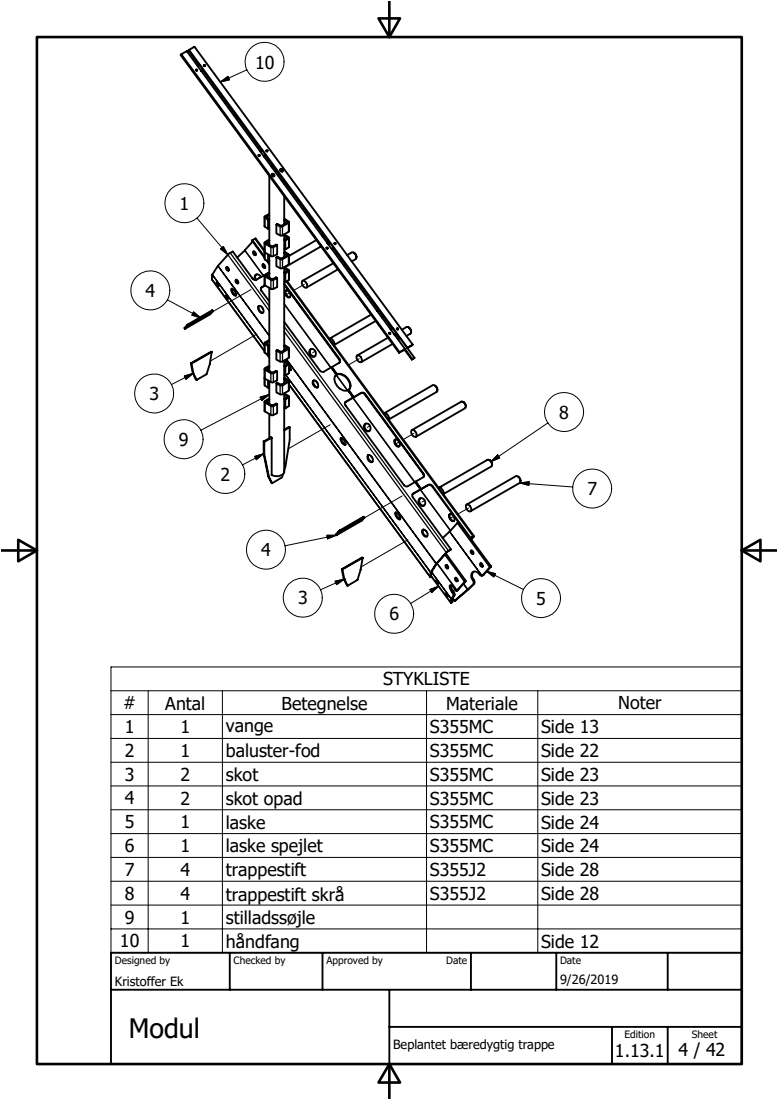
[picture p46: page 4]
STYKLISTE; Antal; Betegnelse; Materiale; Noter; vange; Side 13; baluster-fod; Side 22; skot; Side 23; skot opad; laske; Side 24; laske spejlet; trappestift; Side 28; trappestift skrå; stilladssøjle; håndfang; Side 12

Designed by Kristoffer Ek | Checked by | Approved by Date | Date 9/26/2019
Modul

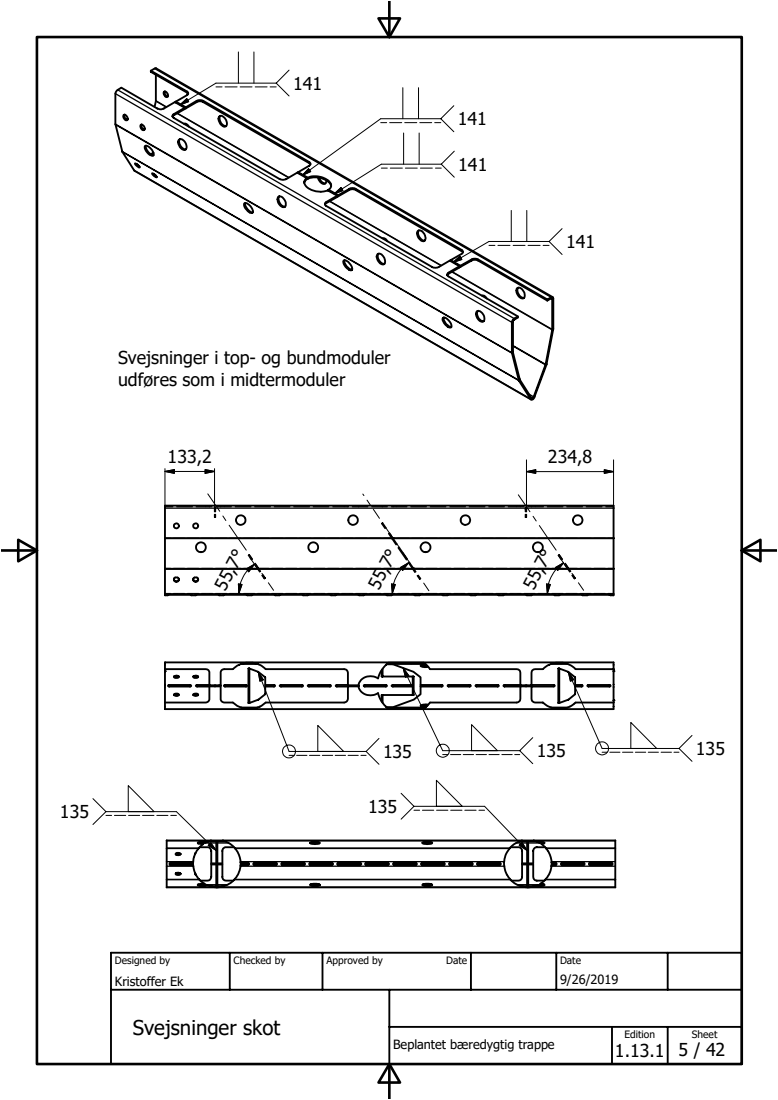
[picture p47: page 5]

Svejsninger i top- og bundmoduler
udføres som i midtermoduler

Designed by Kristoffer Ek | Checked by | Approved by Date | Date 9/26/2019

Svejsninger skot

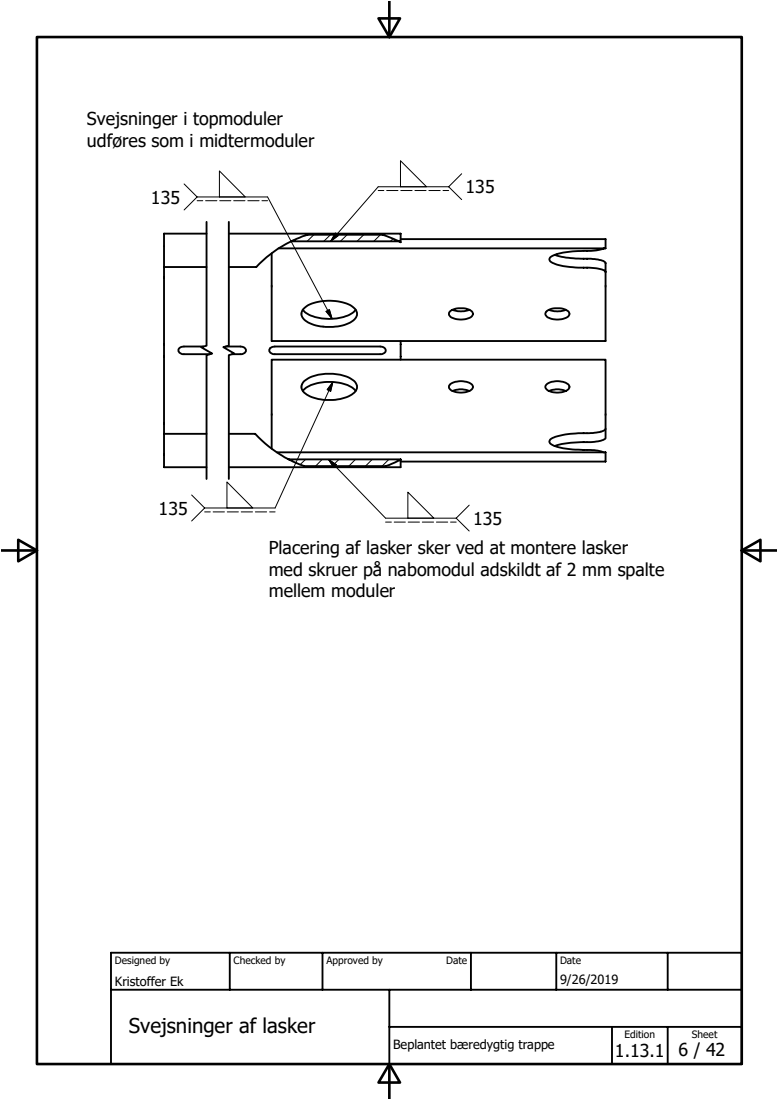
[picture p48: page 6]

Svejsninger i topmoduler
udføres som i midtermoduler

Placering af lasker sker ved at montere lasker
med skruer på nabomodul adskildt af 2 mm spalte
mellem moduler

Designed by Kristoffer Ek | Checked by | Approved by Date | Date 9/26/2019

Svejsninger af lasker

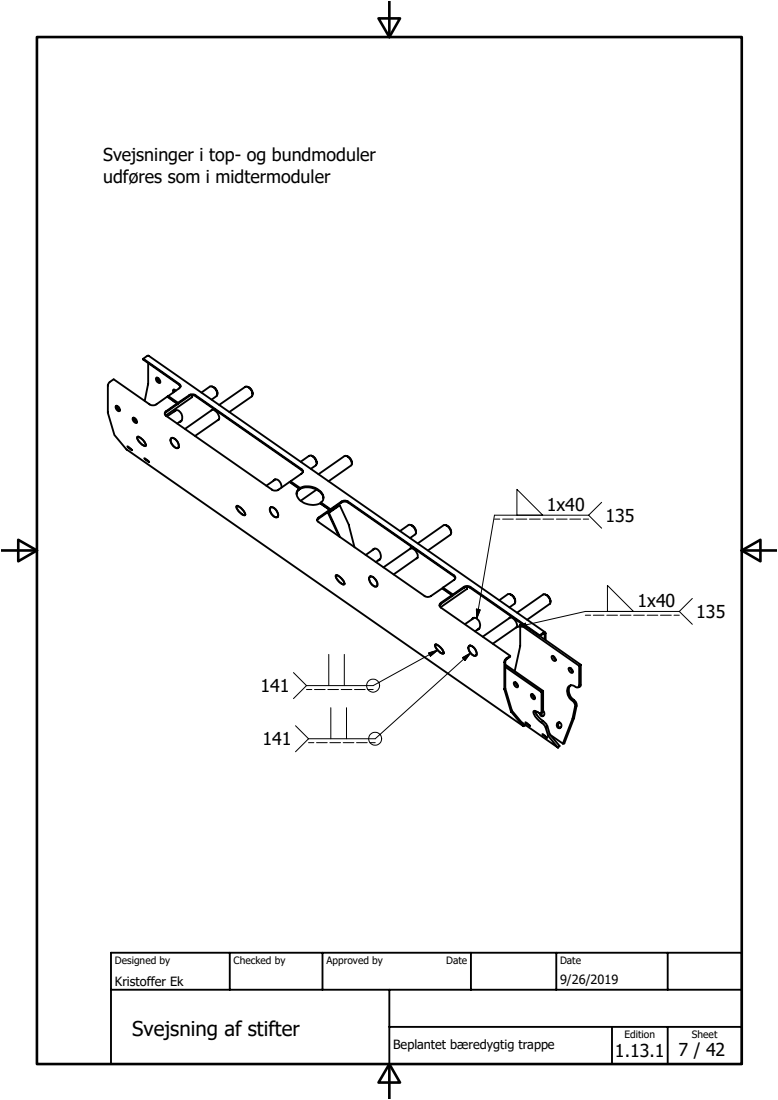
[picture p49: page 7]

Svejsninger i top- og bundmoduler
udføres som i midtermoduler

Designed by Kristoffer Ek | Checked by | Approved by Date | Date 9/26/2019

Beplantet bæredygtig trappe

Svejsning af stifter

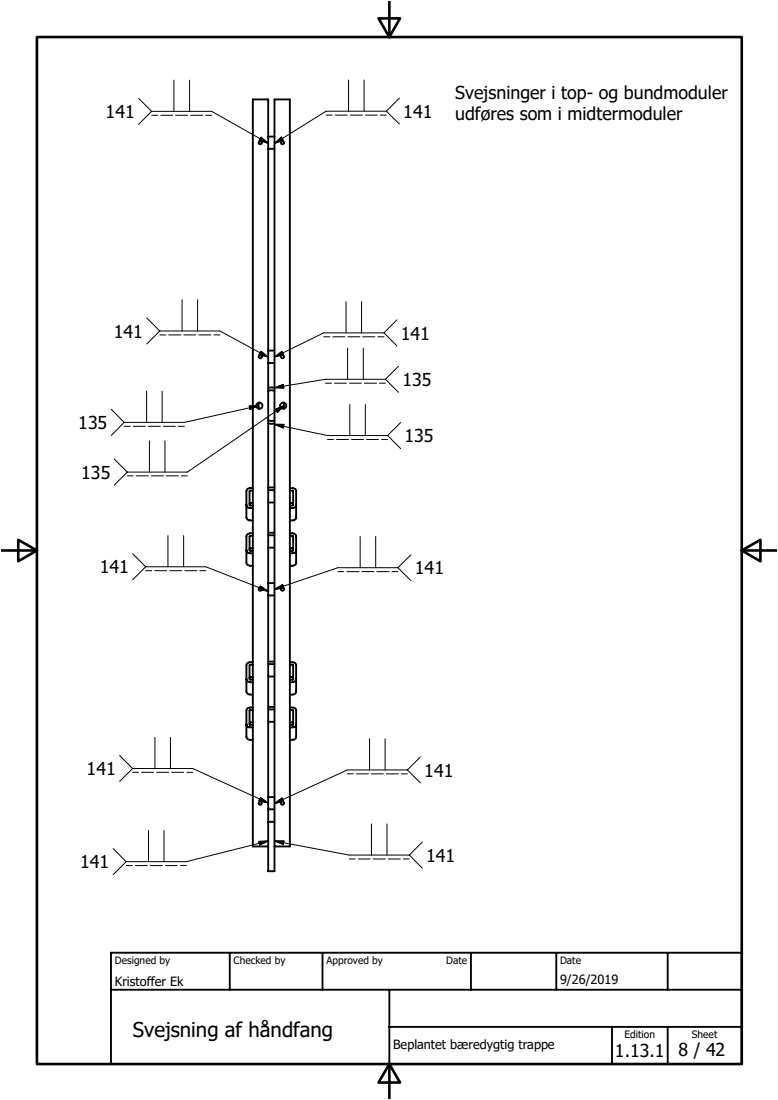
[picture p50: page 8]

Svejsninger i top- og bundmoduler
udføres som i midtermoduler

Designed by Kristoffer Ek | Checked by | Approved by Date | Date 9/26/2019

Beplantet bæredygtig trappe

Svejsning af håndfang

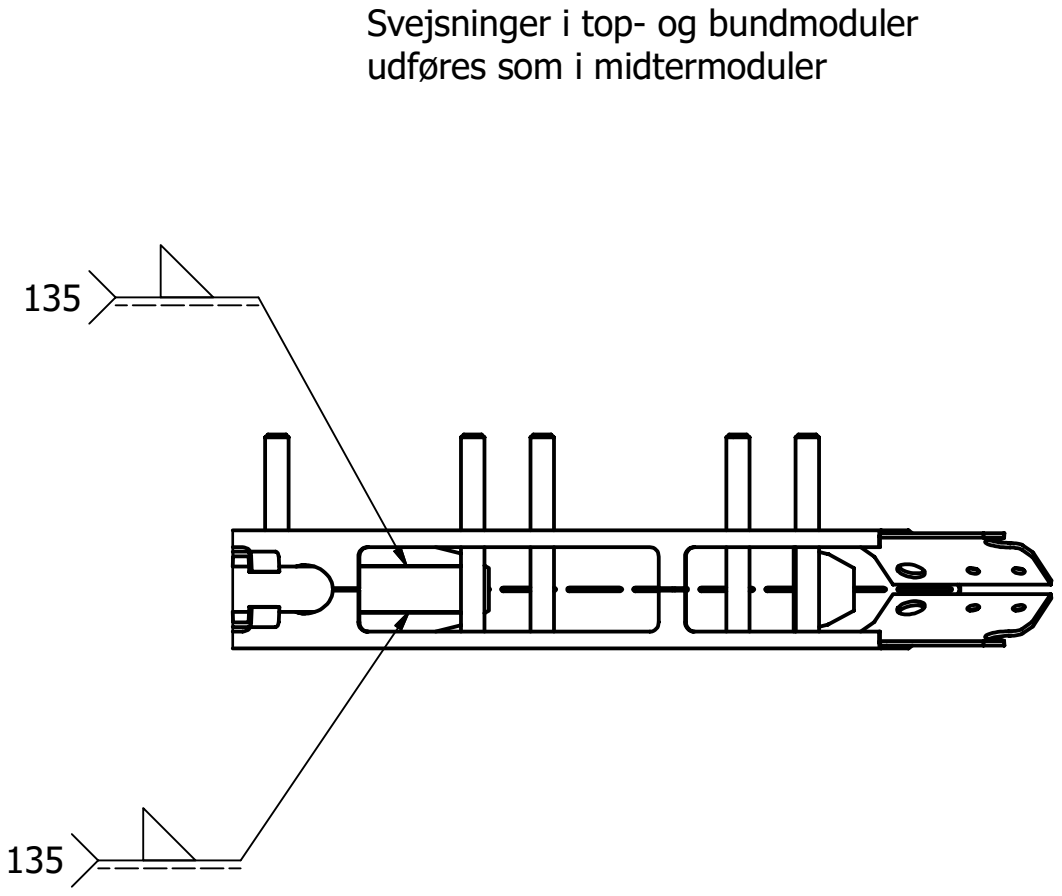
[picture p51: page 9]

Svejsninger i top- og bundmoduler
udføres som i midtermoduler

Designed by Kristoffer Ek | Checked by | Approved by Date | Date 9/26/2019

Svejsning af baluster på vange

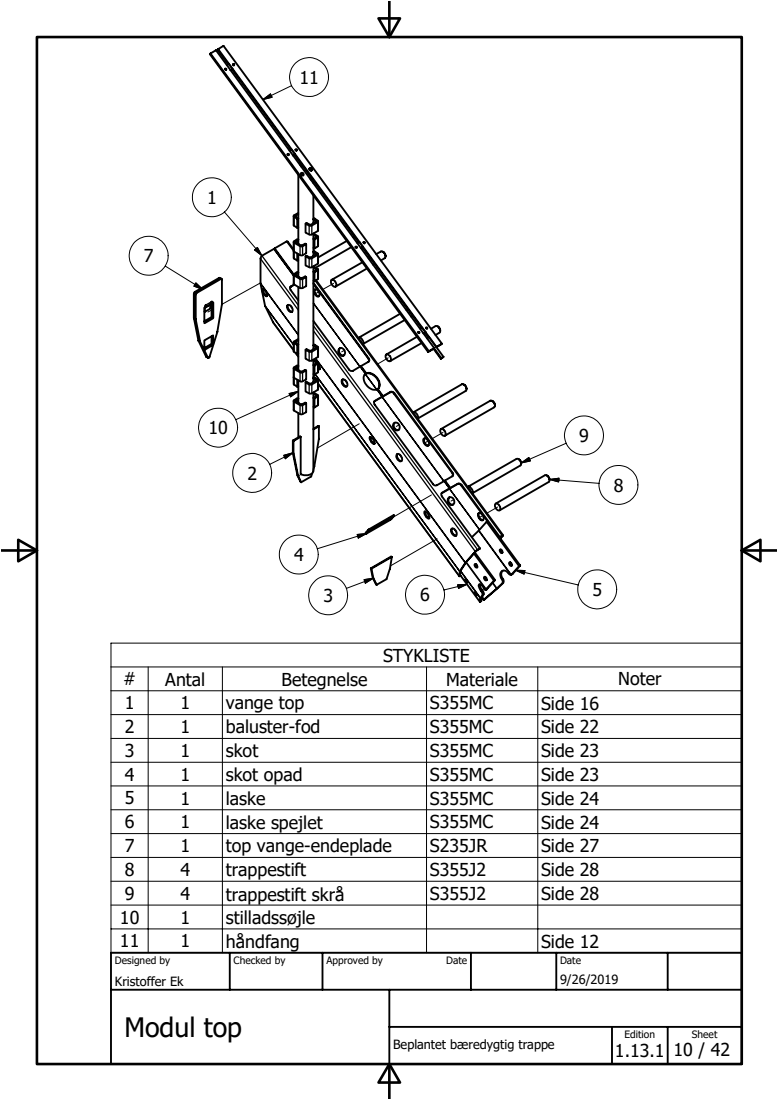
[picture p52: page 10]
Modul top; Beplantet bæredygtig trappe; Kristoffer Ek; Designed by; Checked by; Approved by; Date; STYKLISTE; Antal; Betegnelse; Materiale; Noter; vange top; Side 16; baluster-fod; Side 22; skot; Side 23; skot opad; laske; Side 24; laske spejlet; top vange-endeplade; Side 27; trappestift; Side 28; trappestift skrå; stilladssøjle; håndfang; Side 12

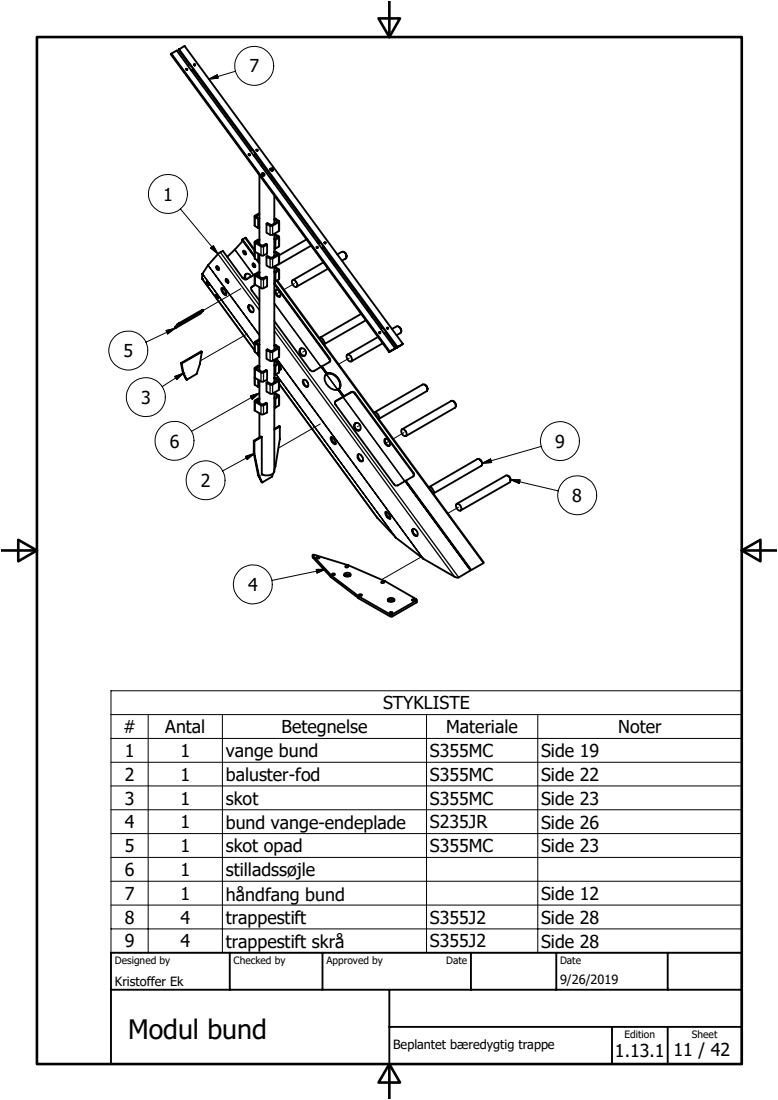
[picture p53: page 11]
Modul bund; Beplantet bæredygtig trappe; Kristoffer Ek; Designed by; Checked by; Approved by; Date; STYKLISTE; Antal; Betegnelse; Materiale; Noter; vange bund; Side 19; baluster-fod; Side 22; skot; Side 23; bund vange-endeplade S235JR; Side 26; skot opad; stilladssøjle; håndfang bund; Side 12; trappestift; Side 28; trappestift skrå

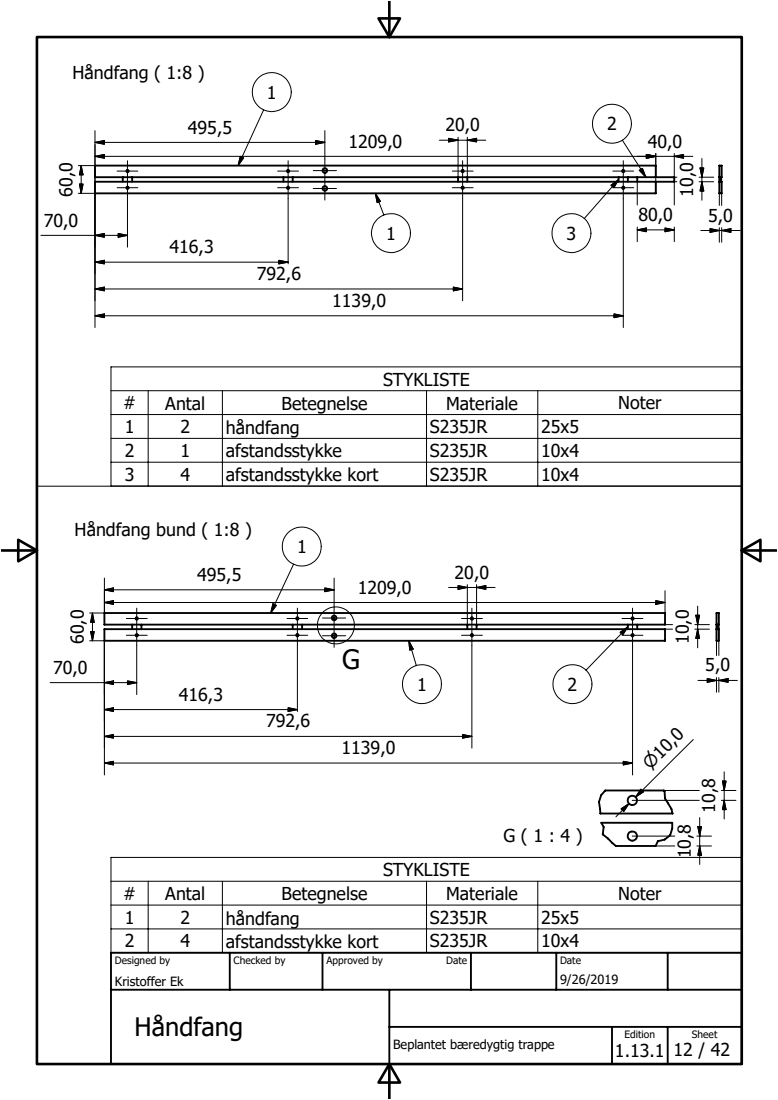
[picture p54: page 12]
Håndfang ( 1:8 ); Håndfang bund ( 1:8 ); STYKLISTE; Antal; Betegnelse; Materiale; Noter; afstandsstykke kort

1 | 2 | håndfang | S235JR | 25x5
2 | 1 | afstandsstykke | S235JR | 10x4

2 | 4 | afstandsstykke kort | S235JR | 10x4
Designed by Kristoffer Ek | Checked by | Approved by Date | | Date 9/26/2019
Håndfang

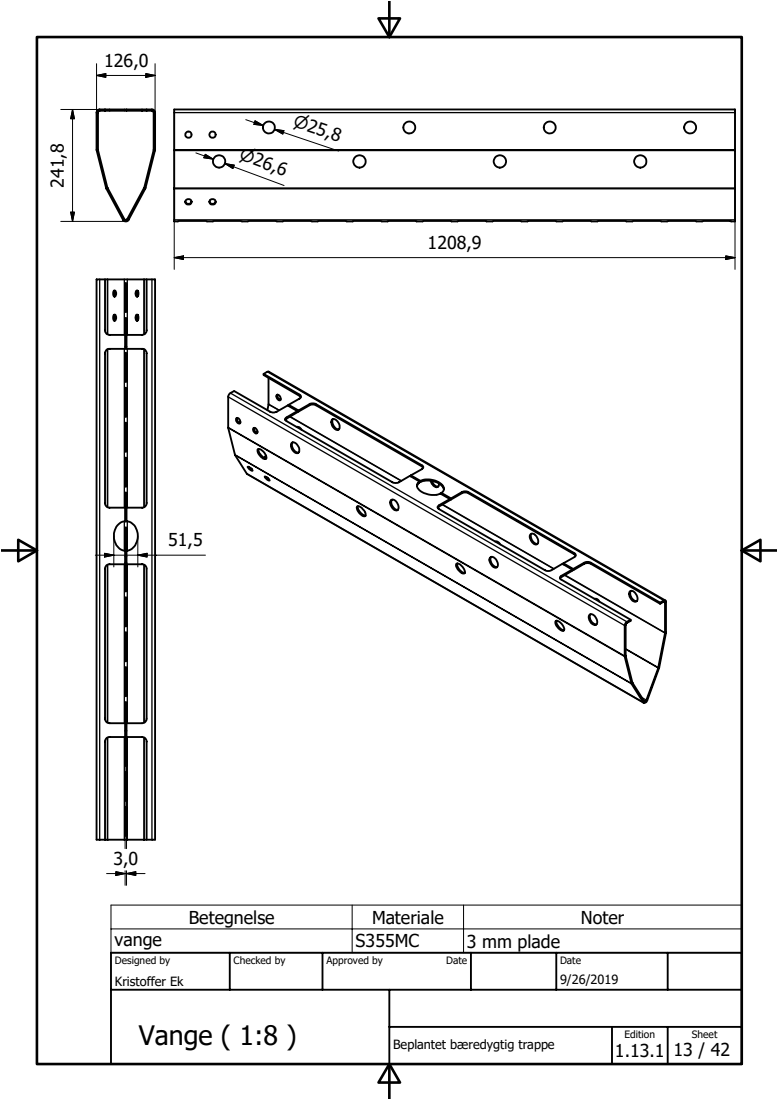
[picture p55: page 13]
Betegnelse; Materiale; Noter

vange | S355MC | 3 mm plade
Designed by Kristoffer Ek | Checked by | Approved by Date | Date 9/26/2019

Beplantet bæredygtig trappe

Vange ( 1:8 )

D

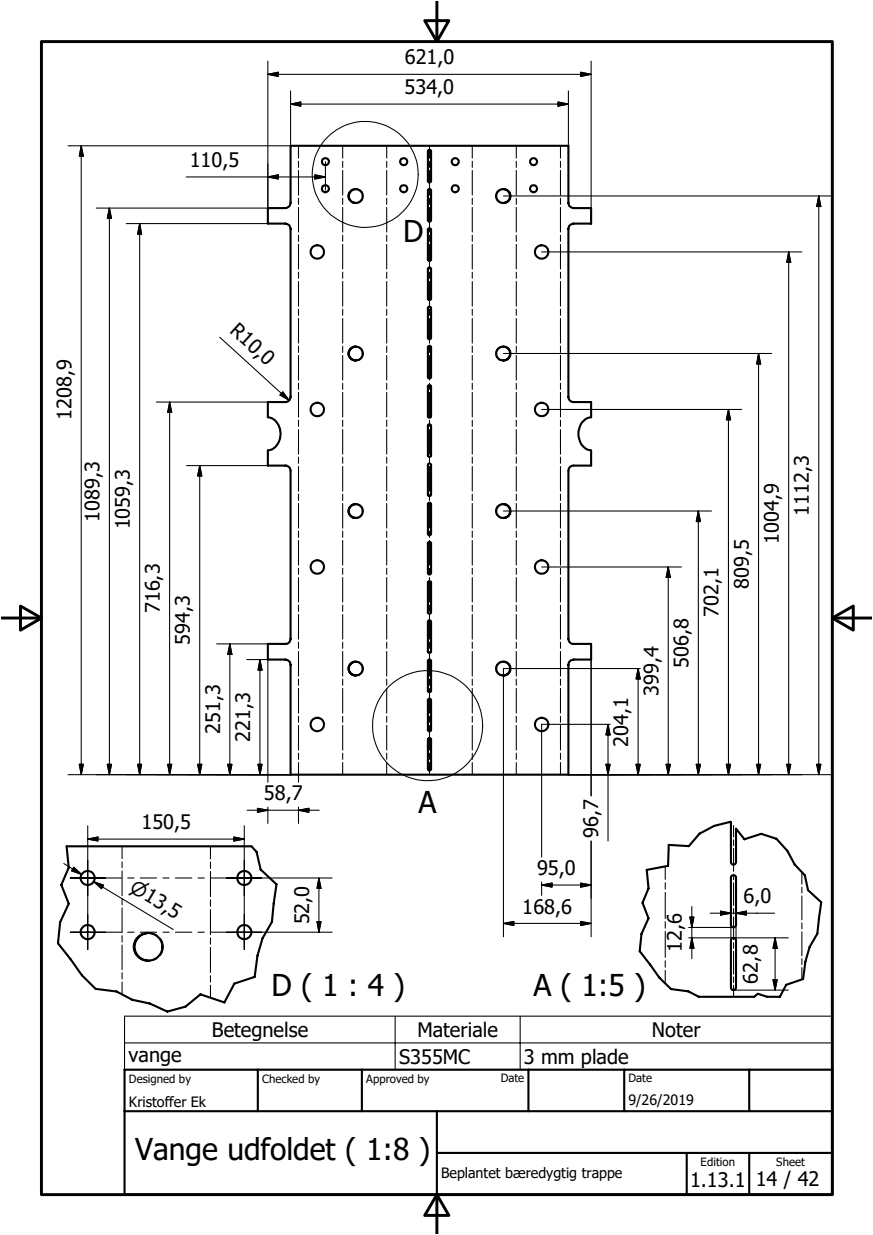
[picture p56: page 14]
Betegnelse; Materiale; Noter

vange | S355MC | 3 mm plade
Designed by Kristoffer Ek | Checked by | Approved by Date | Date 9/26/2019
Vange udfoldet ( 1:8 )

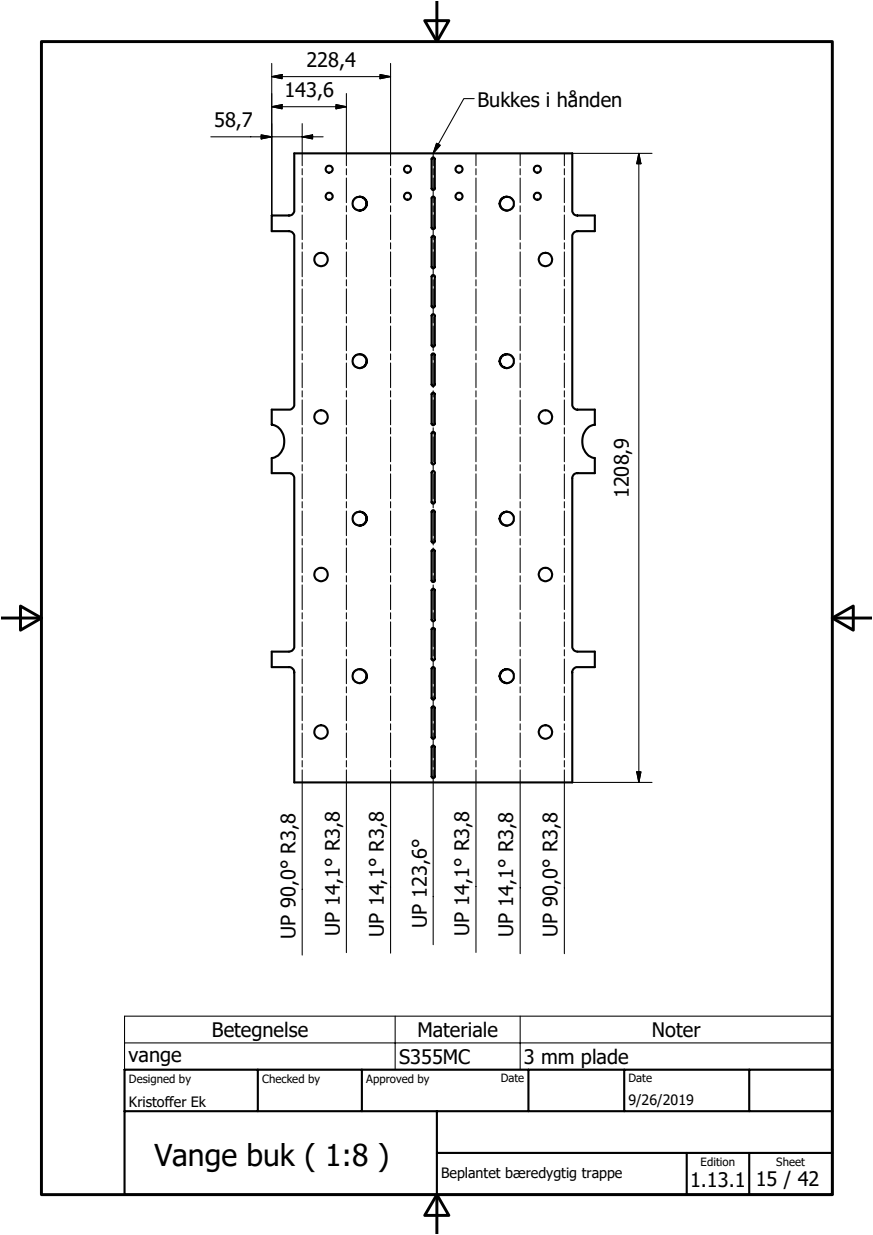
[picture p57: page 15]
Vange buk ( 1:8 ); Beplantet bæredygtig trappe; Betegnelse; Materiale; Noter; Bukkes i hånden

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

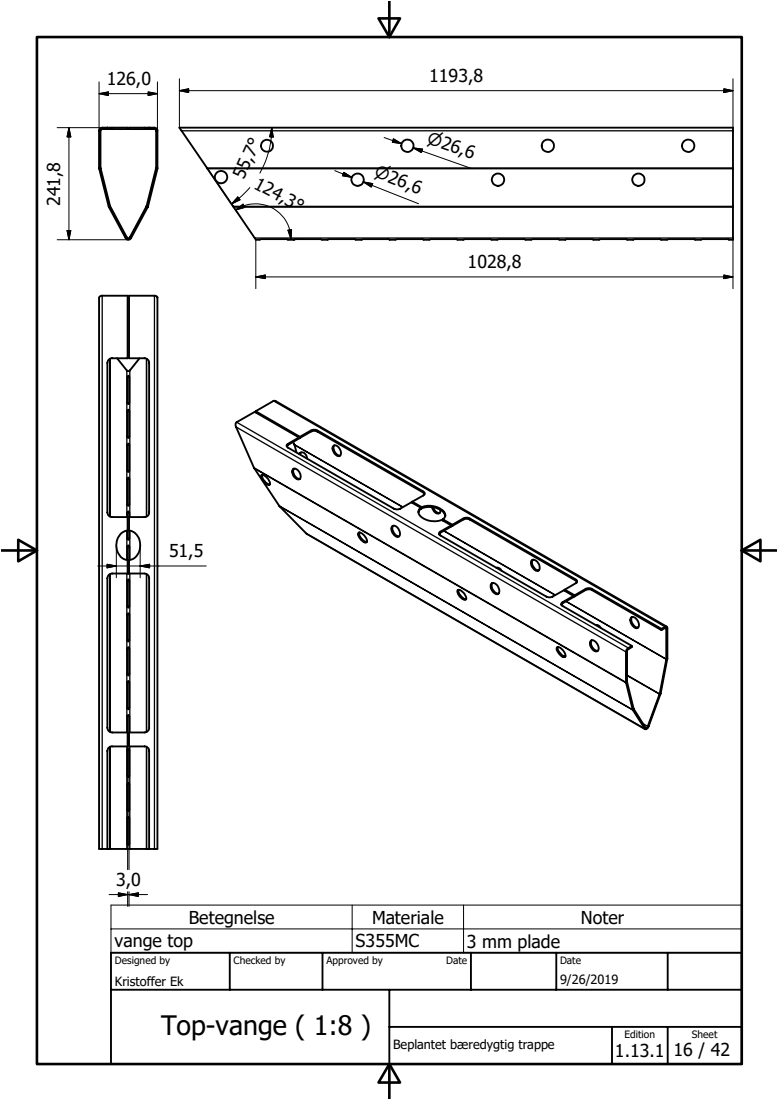
[picture p58: page 16]
Top-vange ( 1:8 ); Beplantet bæredygtig trappe; Betegnelse; Materiale; Noter

vange top | S355MC | 3 mm plade
Designed by Kristoffer Ek | Checked by | Approved by Date | Date 9/26/2019

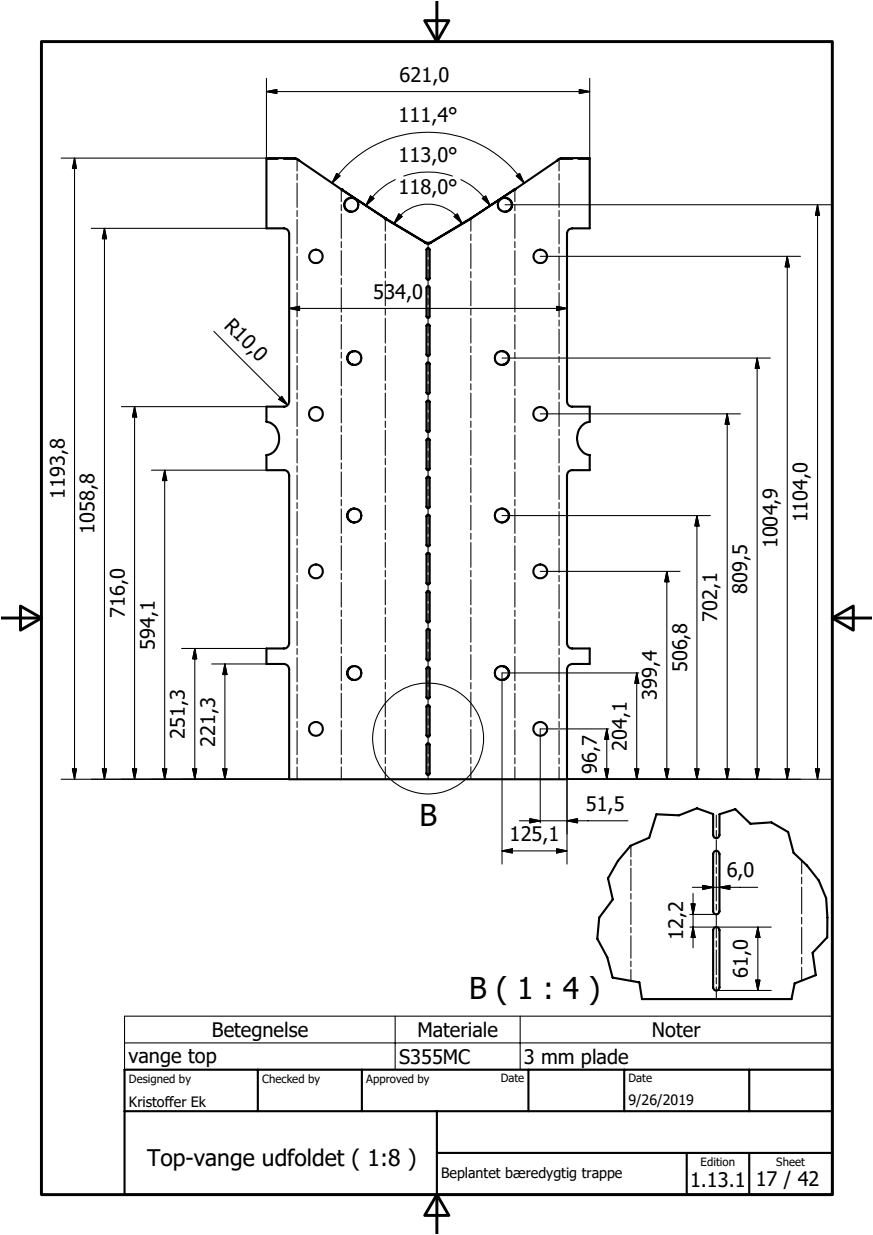
[picture p59: page 17]
Betegnelse; Materiale; Noter

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

Top-vange udfoldet ( 1:8 )

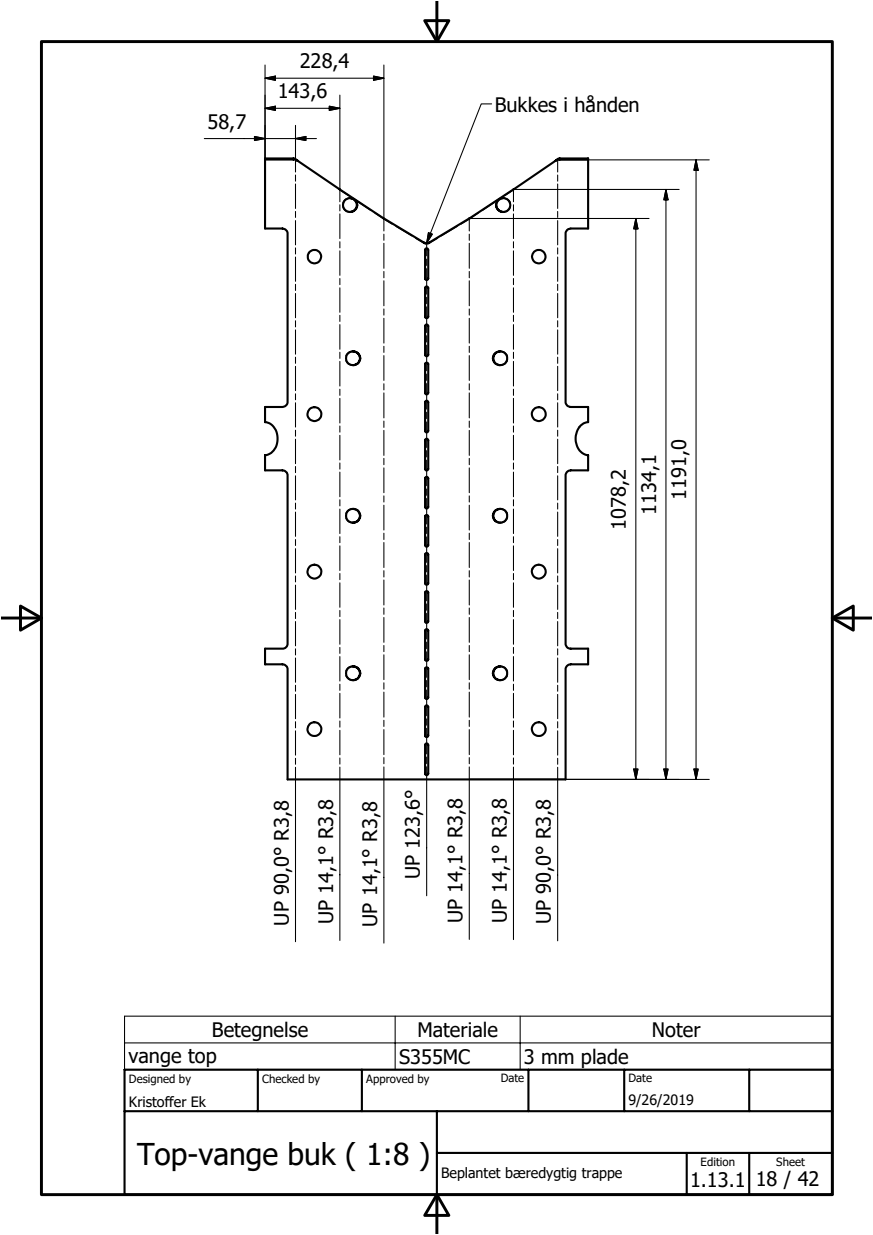
[picture p60: page 18]
Betegnelse; Materiale; Noter; Bukkes i hånden

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

Top-vange buk ( 1:8 ) Beplantet bæredygtig trappe

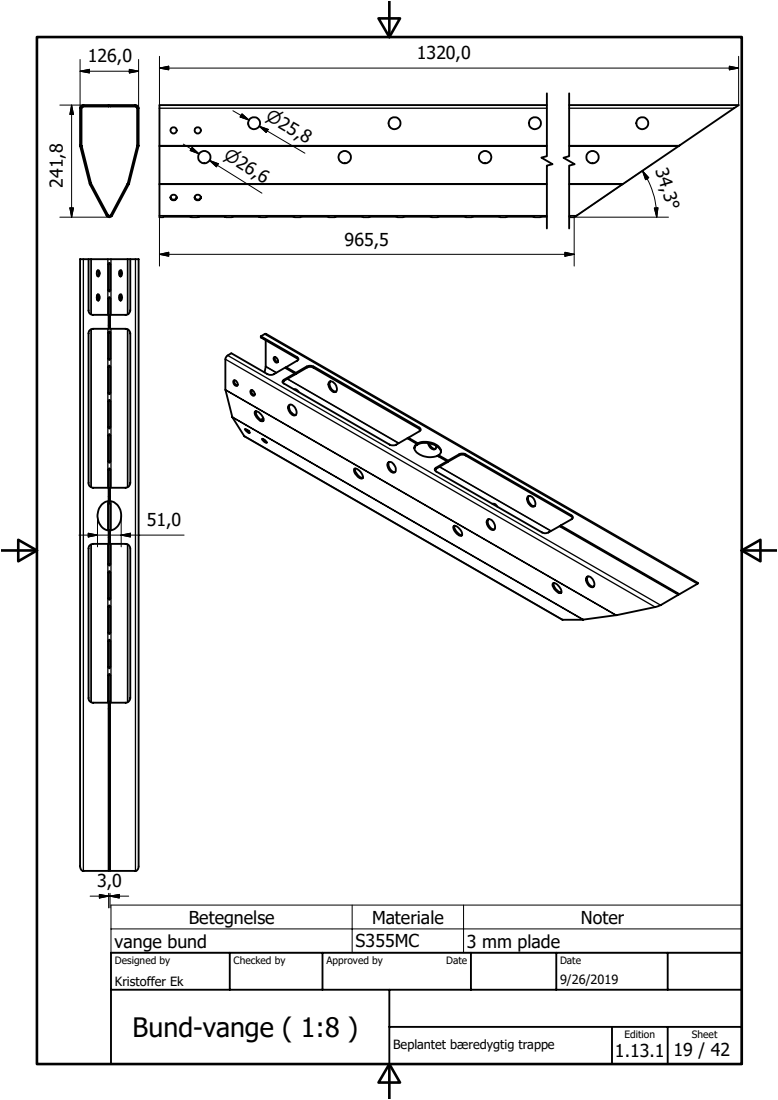
[picture p61: page 19]
Bund-vange ( 1:8 ); Beplantet bæredygtig trappe; Betegnelse; Materiale; Noter

vange bund | S355MC | 3 mm plade
Designed by Kristoffer Ek | Checked by | Approved by Date | Date 9/26/2019

E

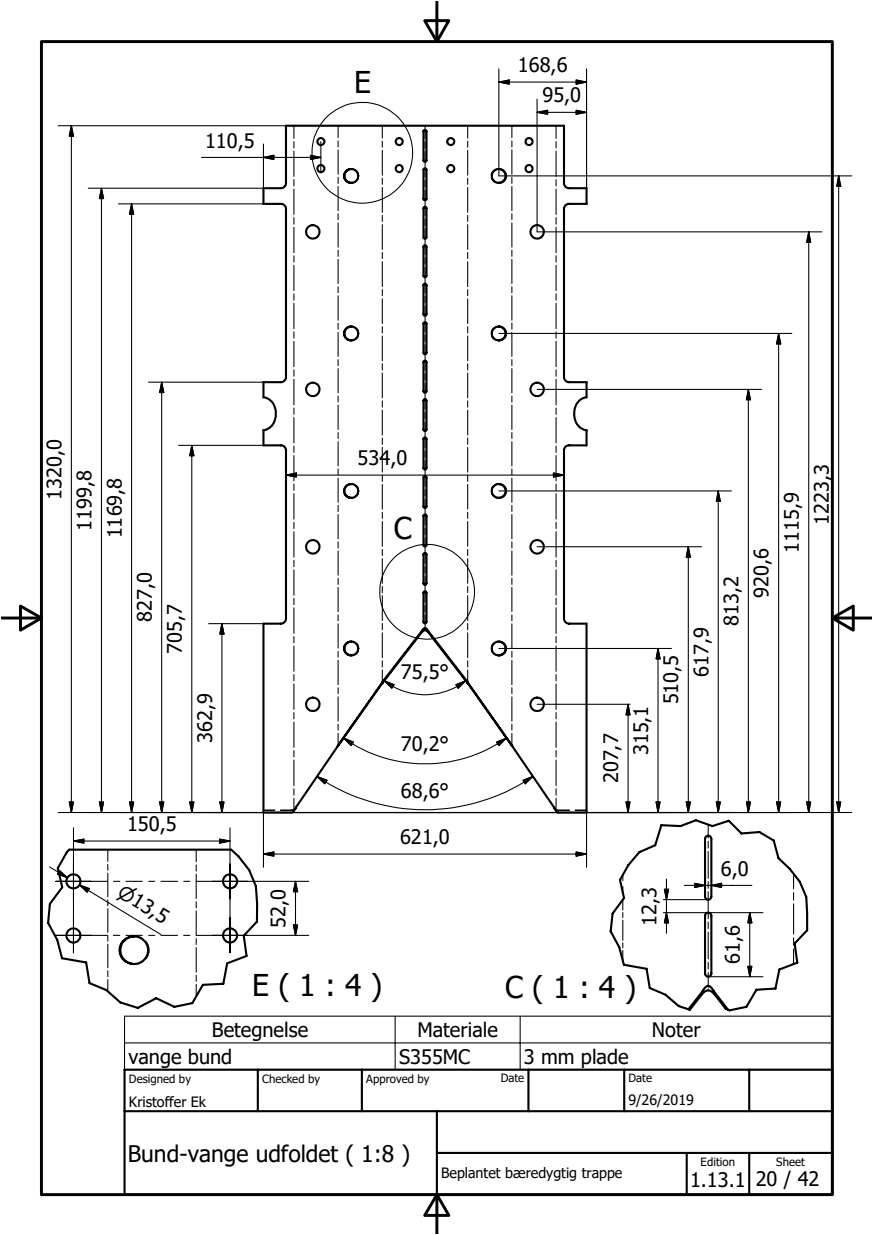
[picture p62: page 20]
Betegnelse; Materiale; Noter

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

Bund-vange udfoldet ( 1:8 )

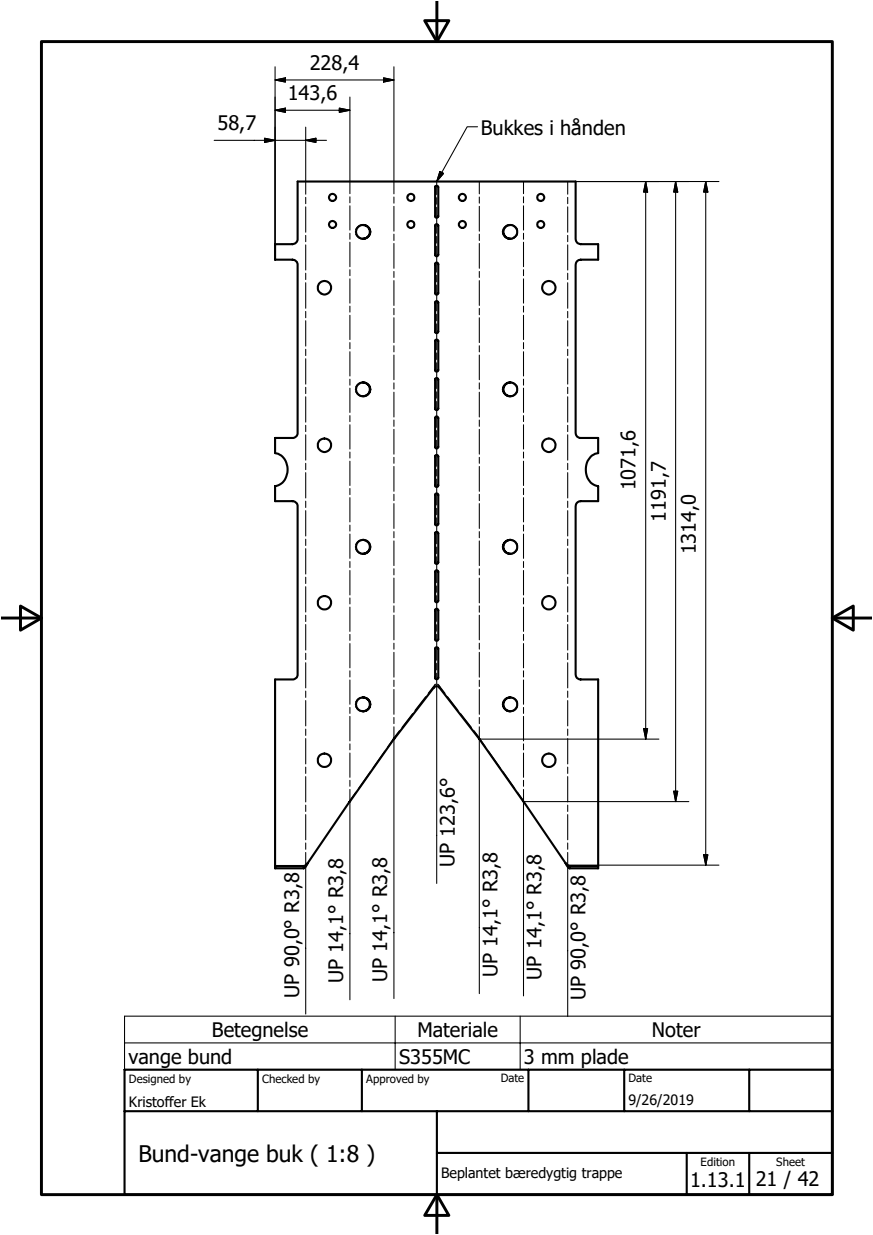
[picture p63: page 21]
Betegnelse; Materiale; Noter; Bukkes i hånden

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

Bund-vange buk ( 1:8 )

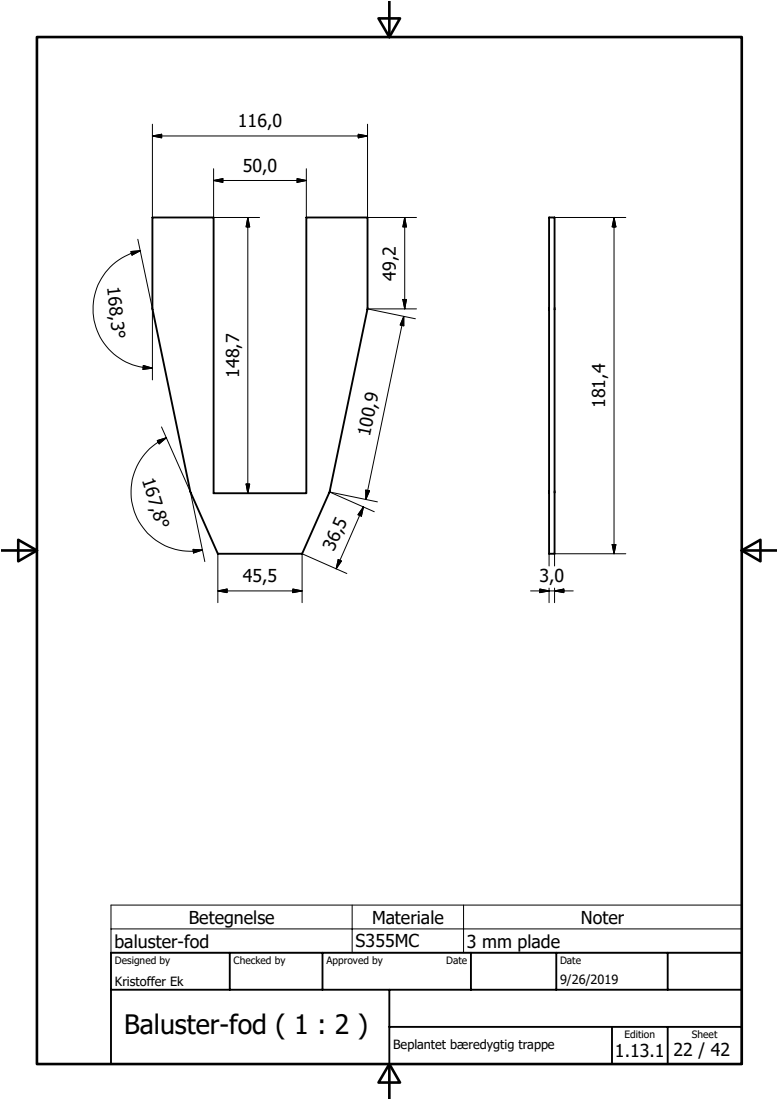
[picture p64: page 22]
Baluster-fod ( 1 : 2 ); Beplantet bæredygtig trappe; Betegnelse; Materiale; Noter

baluster-fod | S355MC | 3 mm plade
Designed by Kristoffer Ek | Checked by | Approved by Date | Date 9/26/2019

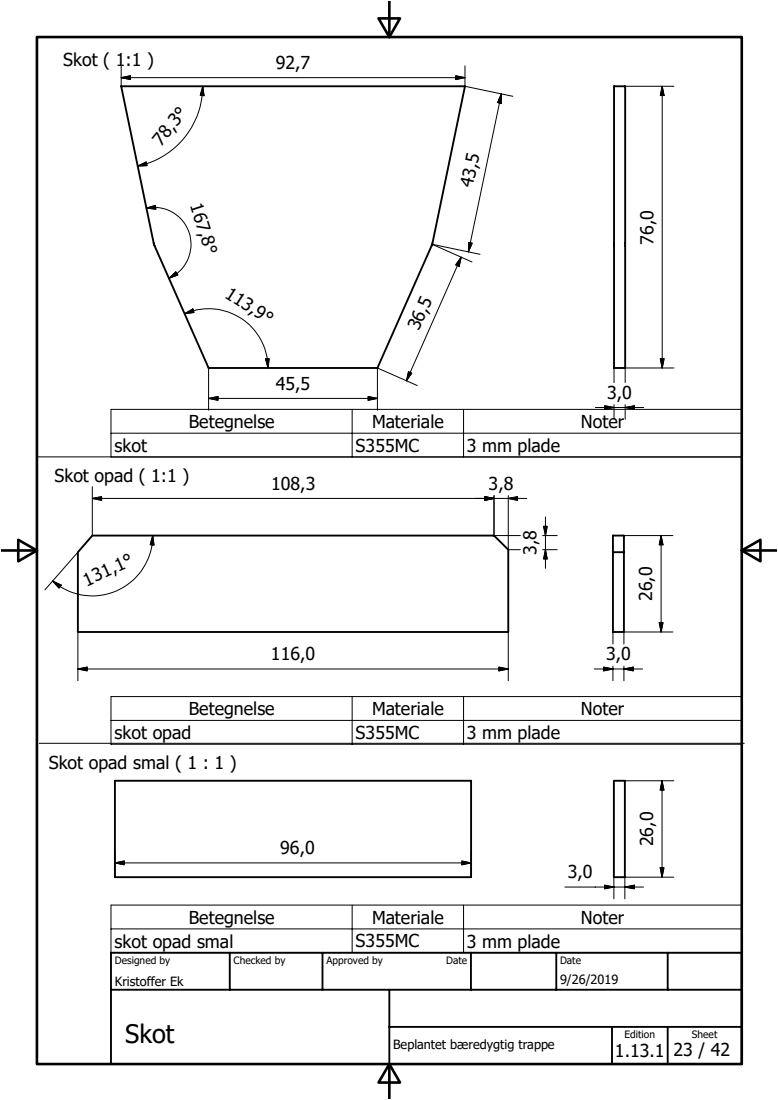
[picture p65: page 23]
Skot ( 1:1 ); Skot opad ( 1:1 ); Betegnelse; Materiale; Noter; skot; 3 mm plade

Betegnelse | Materiale | Noter

skot opad | S355MC | 3 mm plade

Skot opad smal ( 1 : 1 )

skot opad smal | S355MC | 3 mm plade
Designed by Kristoffer Ek | Checked by | Approved by Date | Date 9/26/2019

Skot

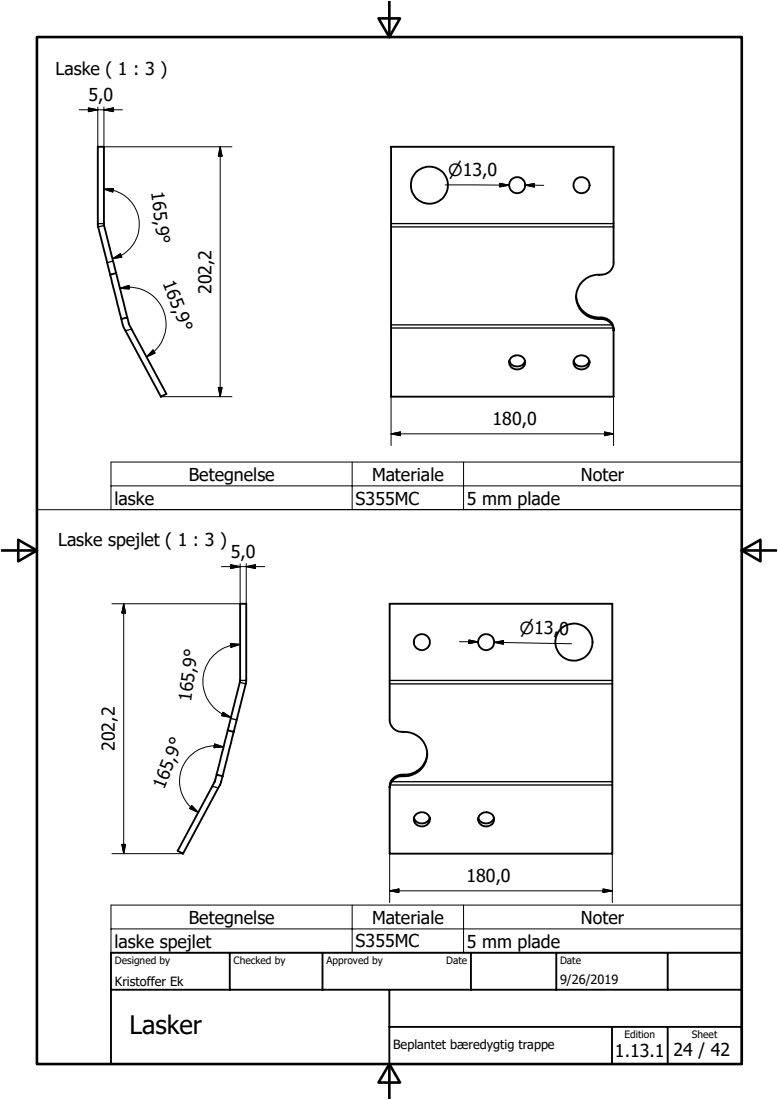
[picture p66: page 24]
Laske ( 1 : 3 ); Laske spejlet ( 1 : 3 ); Betegnelse; Materiale; Noter; laske; 5 mm plade

Betegnelse | Materiale | Noter

laske spejlet | S355MC | 5 mm plade
Designed by Kristoffer Ek | Checked by | Approved by Date | Date 9/26/2019
Lasker

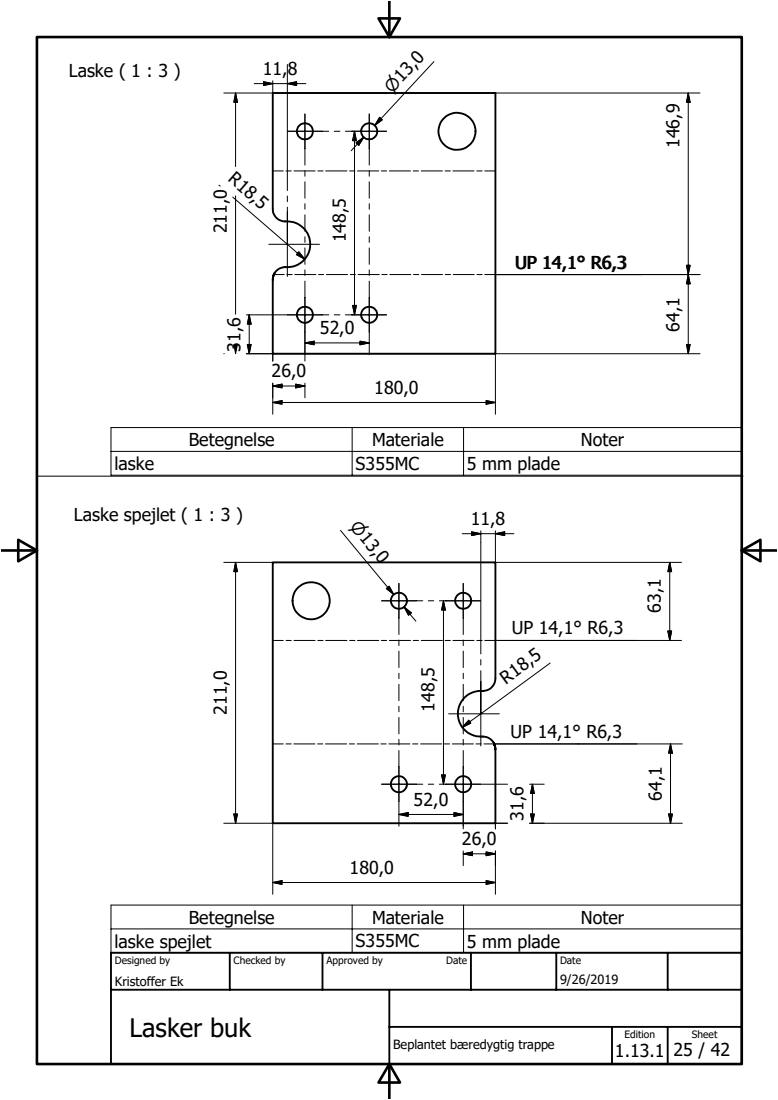
[picture p67: page 25]
Laske ( 1 : 3 ); Laske spejlet ( 1 : 3 ); Betegnelse; Materiale; Noter; laske; 5 mm plade

Betegnelse | Materiale | Noter

laske spejlet | S355MC | 5 mm plade
Designed by Kristoffer Ek | Checked by | Approved by Date | Date 9/26/2019
Lasker buk

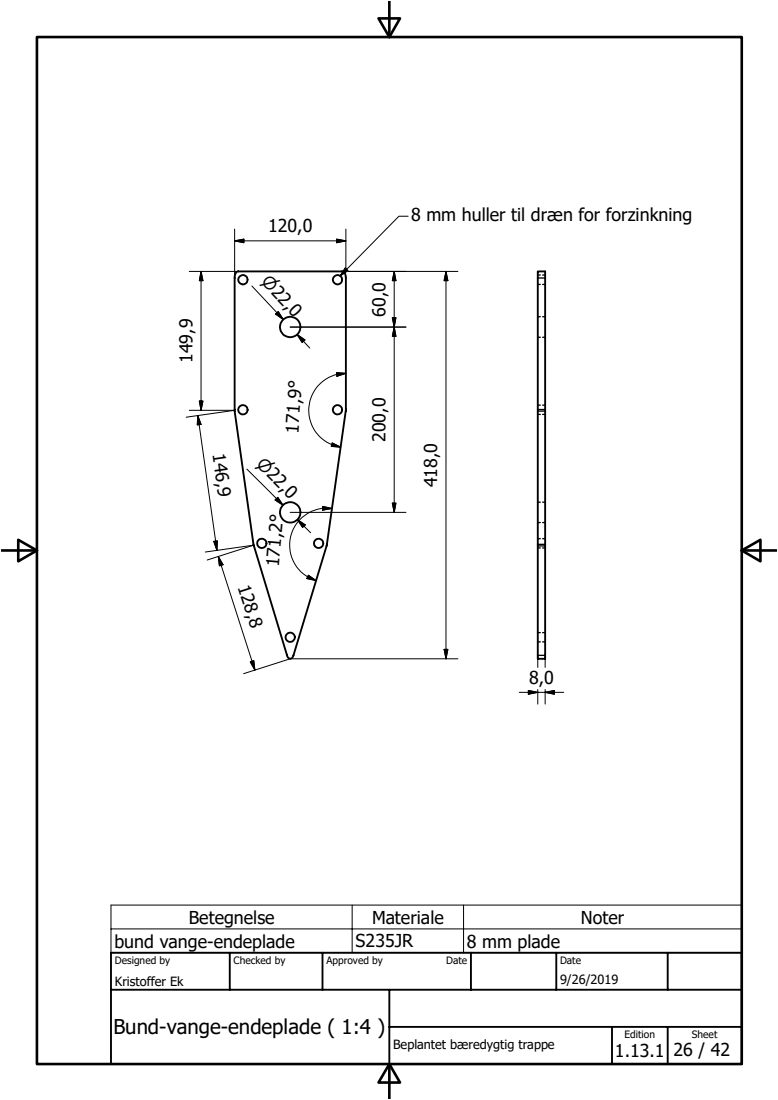
[picture p68: page 26]
Betegnelse; Materiale; Noter

8 mm huller til dræn for forzinkning

bund vange-endeplade | S235JR | 8 mm plade
Designed by Kristoffer Ek | Checked by | Approved by Date | Date 9/26/2019

Bund-vange-endeplade ( 1:4 )

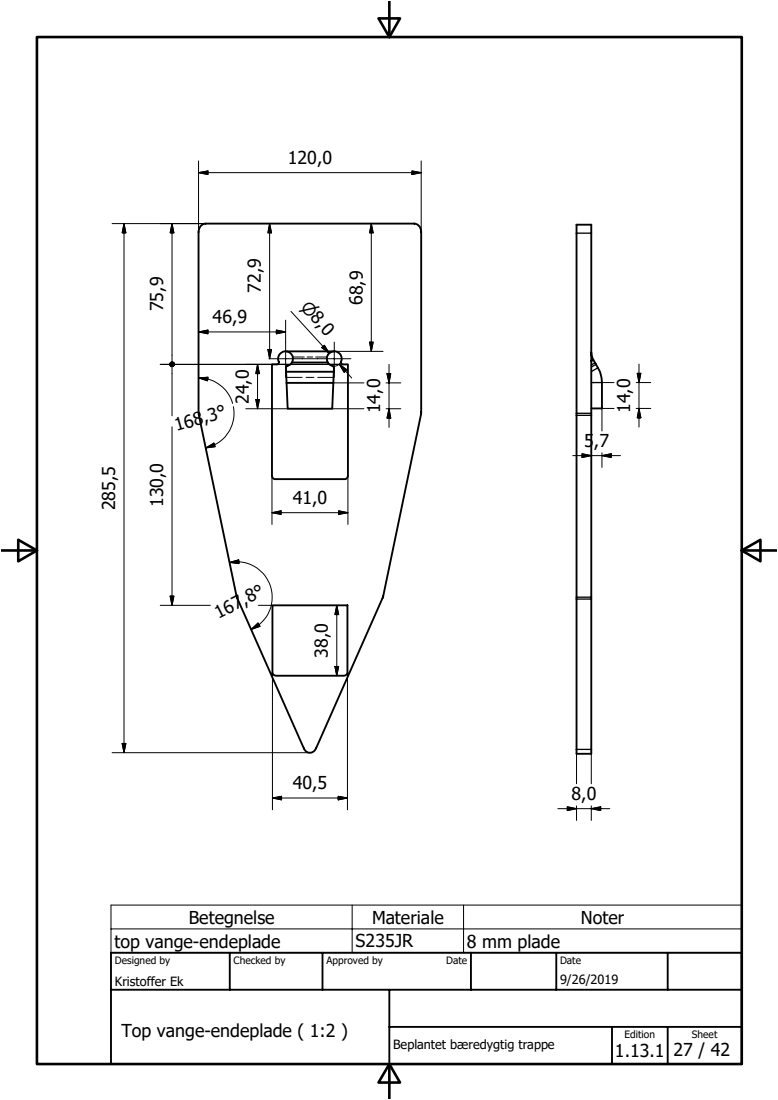
[picture p69: page 27]
Betegnelse; Materiale; Noter

top vange-endeplade | S235JR | 8 mm plade
Designed by Kristoffer Ek | Checked by | Approved by Date | Date 9/26/2019

Beplantet bæredygtig trappe

Top vange-endeplade ( 1:2 )

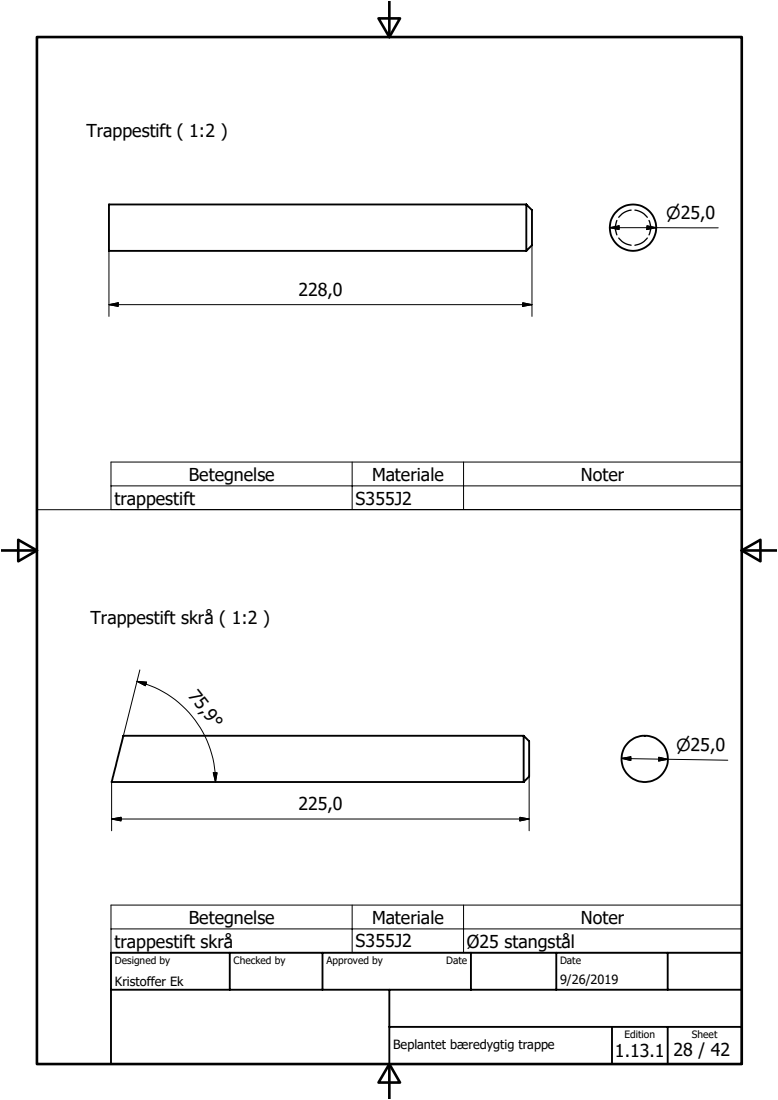
[picture p70: page 28]
Trappestift ( 1:2 ); Trappestift skrå ( 1:2 ); Betegnelse; Materiale; Noter; trappestift

Betegnelse | Materiale | Noter

trappestift skrå | S355J2 | Ø25 stangstål
Designed by Kristoffer Ek | Checked by | Approved by Date | Date 9/26/2019

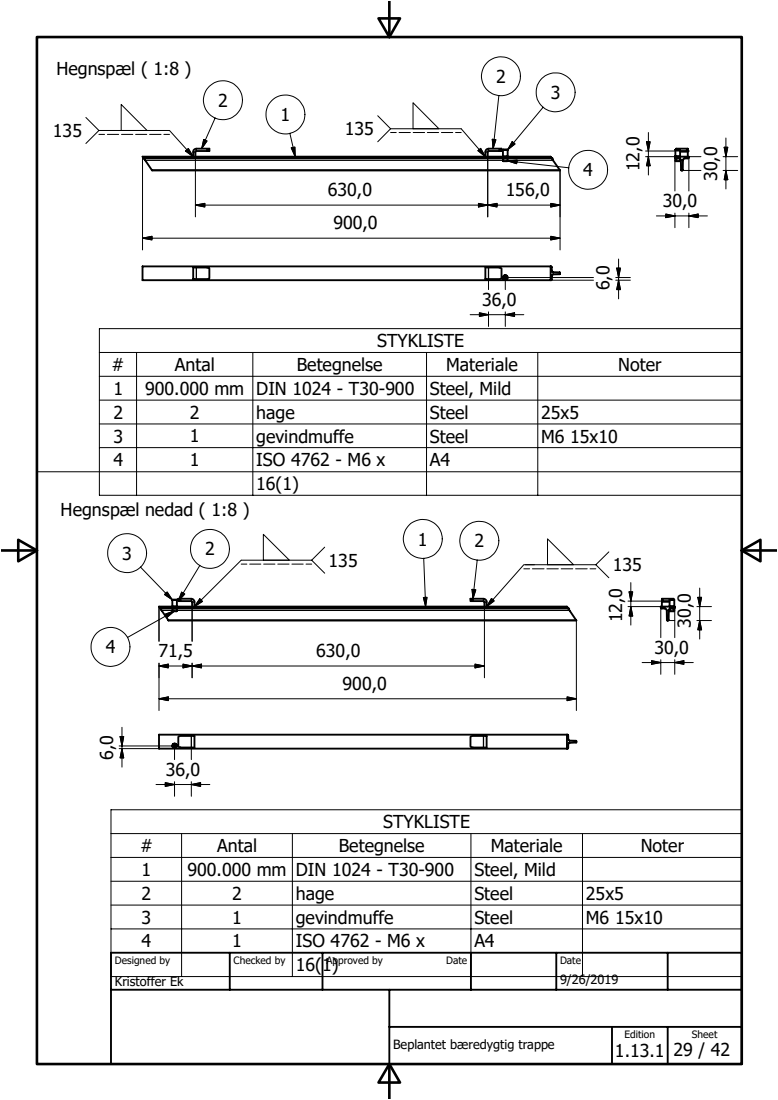
[picture p71: page 29]
Hegnspæl ( 1:8 ); Hegnspæl nedad ( 1:8 ); Kristoffer Ek; Designed by; Checked by; Approved by; Date; STYKLISTE; Antal; Betegnelse; Materiale; Noter; 900.000 mm DIN 1024 - T30-900 Steel, Mild; hage; Steel; gevindmuffe; ISO 4762 - M6 x

1 | 900.000 mm | DIN 1024 - T30-900 | Steel, Mild
2 | 2 | hage | Steel | 25x5
3 | 1 | gevindmuffe | Steel | M6 15x10
4 | 1 | ISO 4762 - M6 x 16(1) | A4

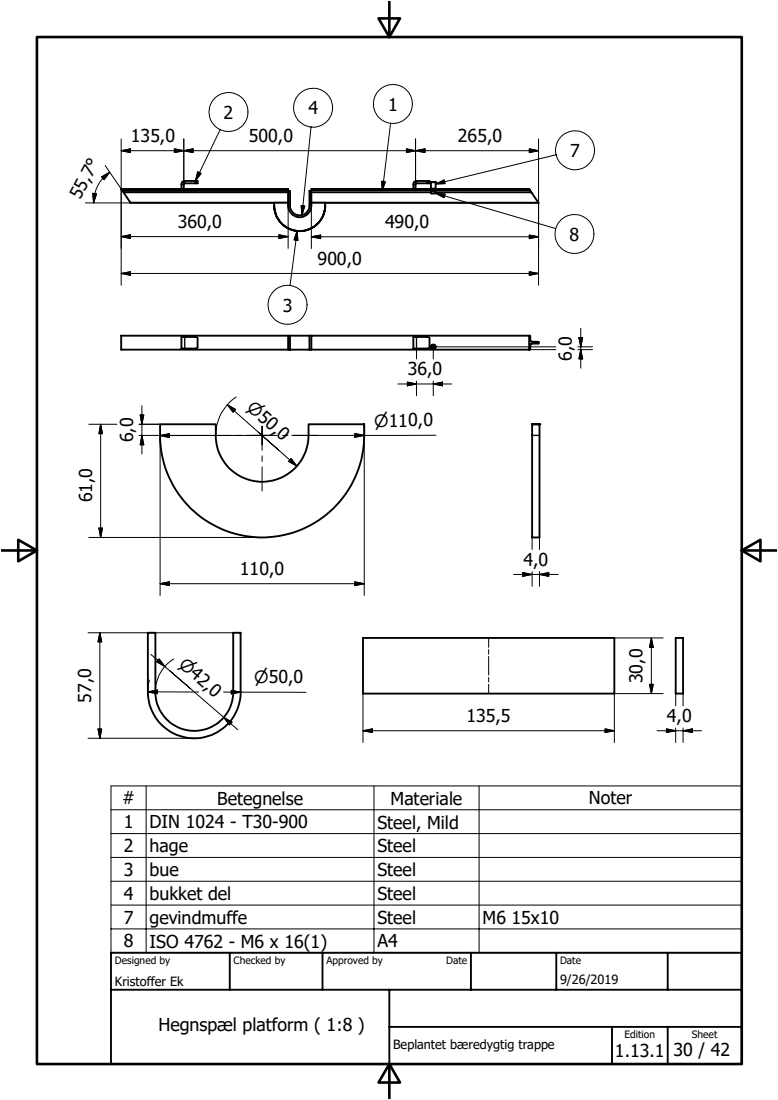
[picture p72: page 30]
Betegnelse; Materiale; Noter

1 | DIN 1024 - T30-900 | Steel, Mild
2 | hage | Steel
3 | bue | Steel
4 | bukket del | Steel
7 | gevindmuffe | Steel | M6 15x10
8 | ISO 4762 - M6 x 16(1) | A4
Designed by Kristoffer Ek | Checked by | Approved by Date | | Date 9/26/2019

Hegnspæl platform ( 1:8 )

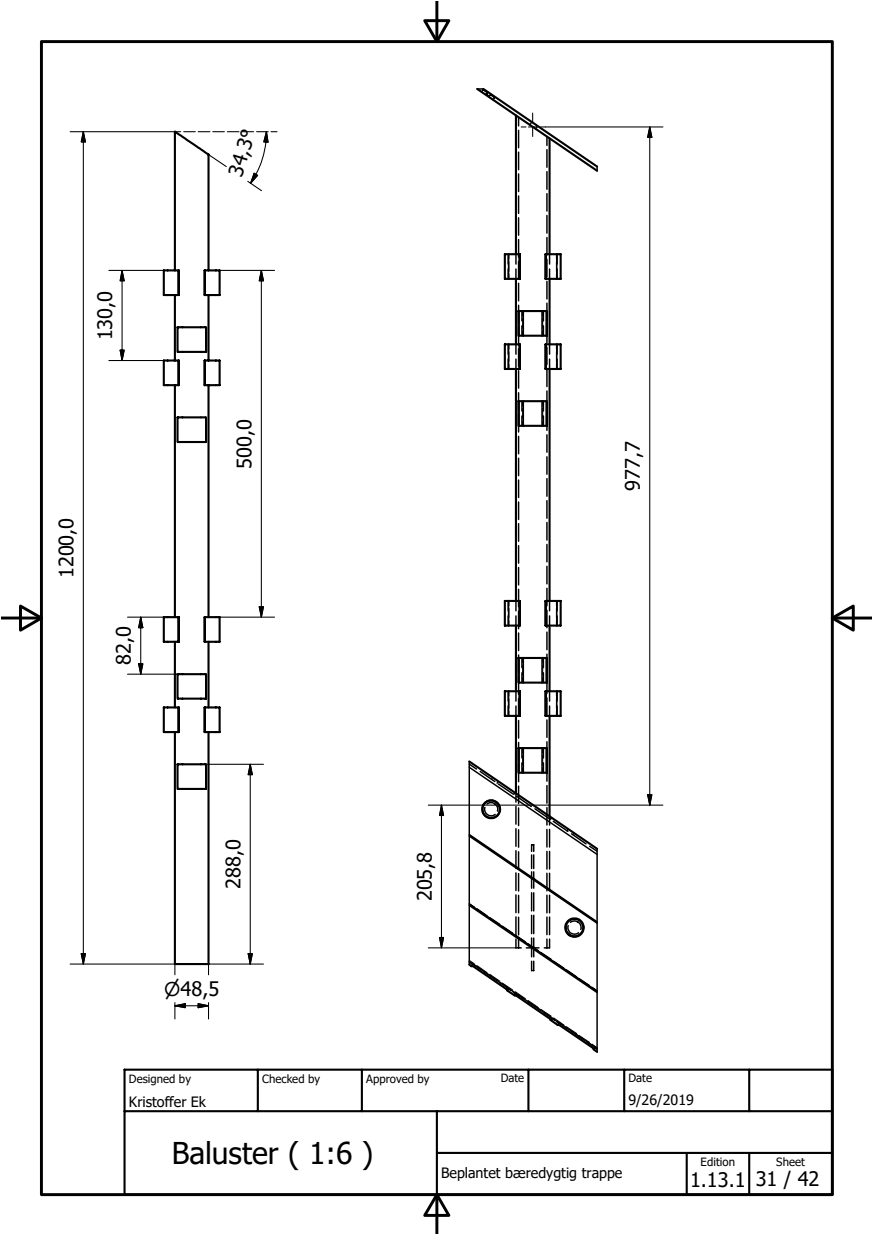
[picture p73: page 31]
Baluster ( 1:6 ); Beplantet bæredygtig trappe; Kristoffer Ek; Designed by; Checked by; Approved by; Date

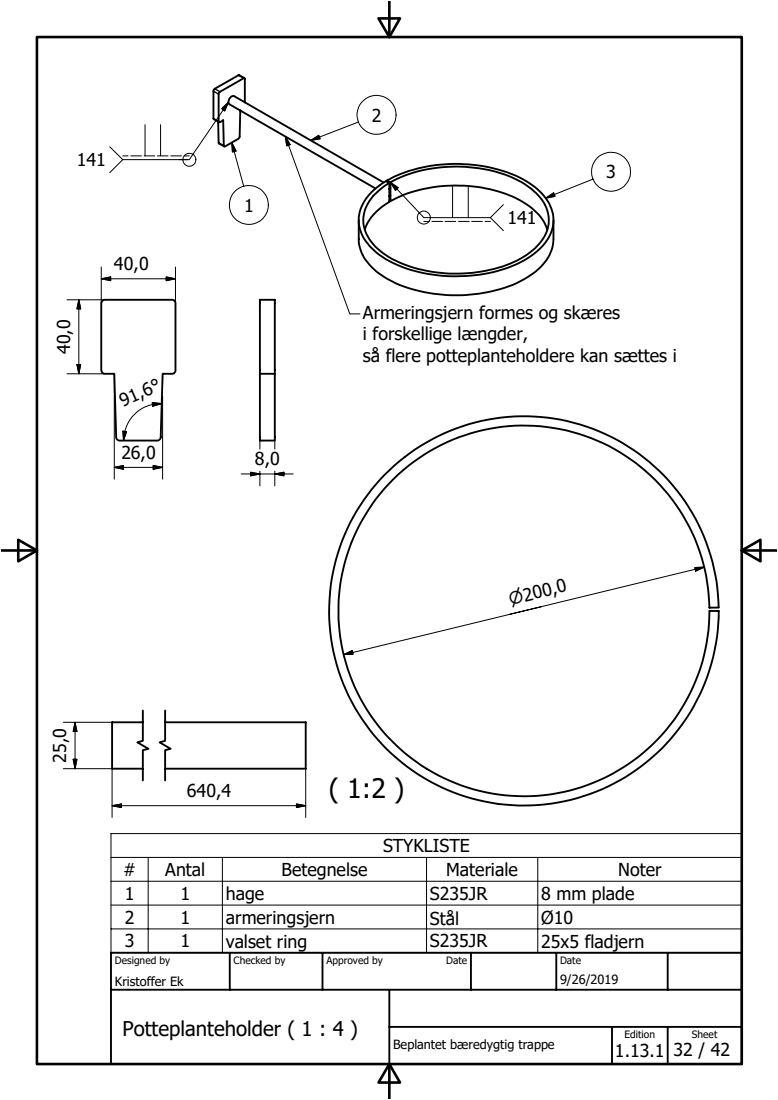
[picture p74: page 32]
STYKLISTE; Antal; Betegnelse; Materiale; Noter; hage; 8 mm plade; armeringsjern; Stål; valset ring; 25x5 fladjern

Armeringsjern formes og skæres
i forskellige længder,
så flere potteplanteholdere kan sættes i

Designed by Kristoffer Ek | Checked by | Approved by Date | Date 9/26/2019

Potteplanteholder ( 1 : 4 )

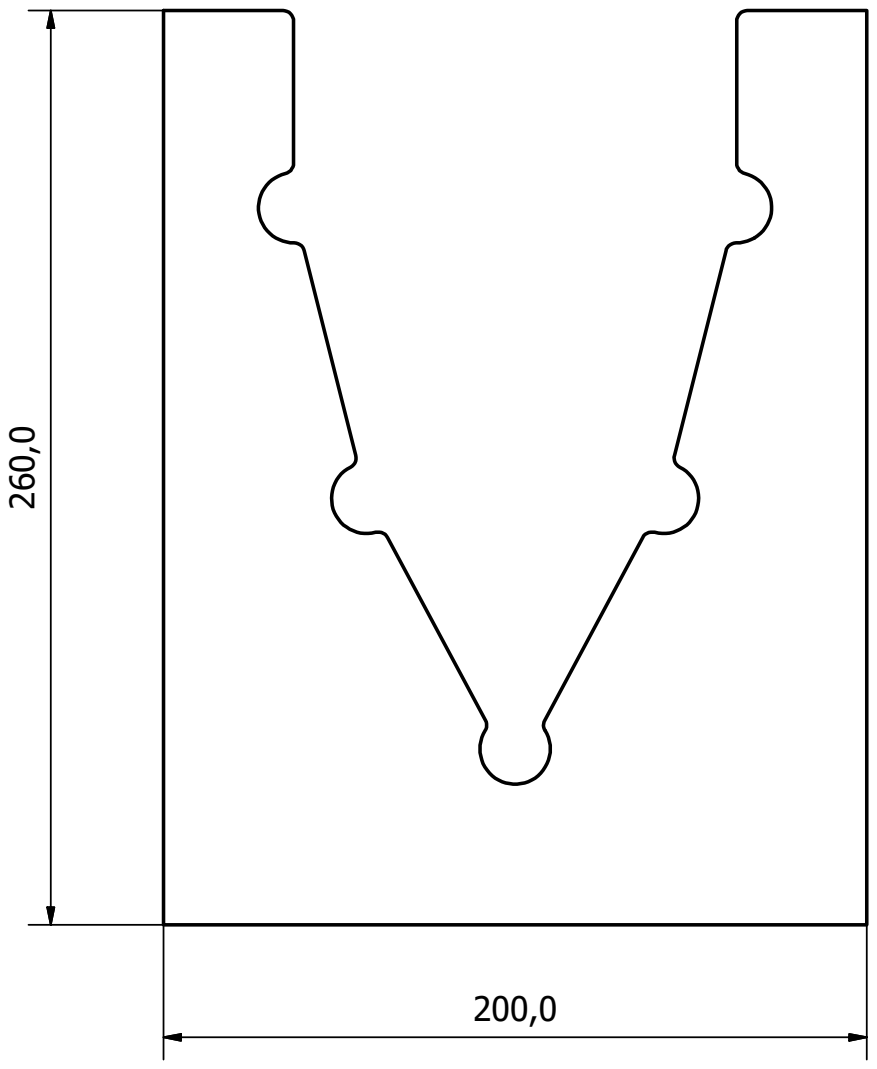
[picture p75: page 33]
Betegnelse; Materiale; Noter

svejselære 1 | Generic | 3 mm plade
Designed by Kristoffer Ek | Checked by | Approved by Date | Date 9/26/2019

Svejselære 1 ( 1 : 2 )

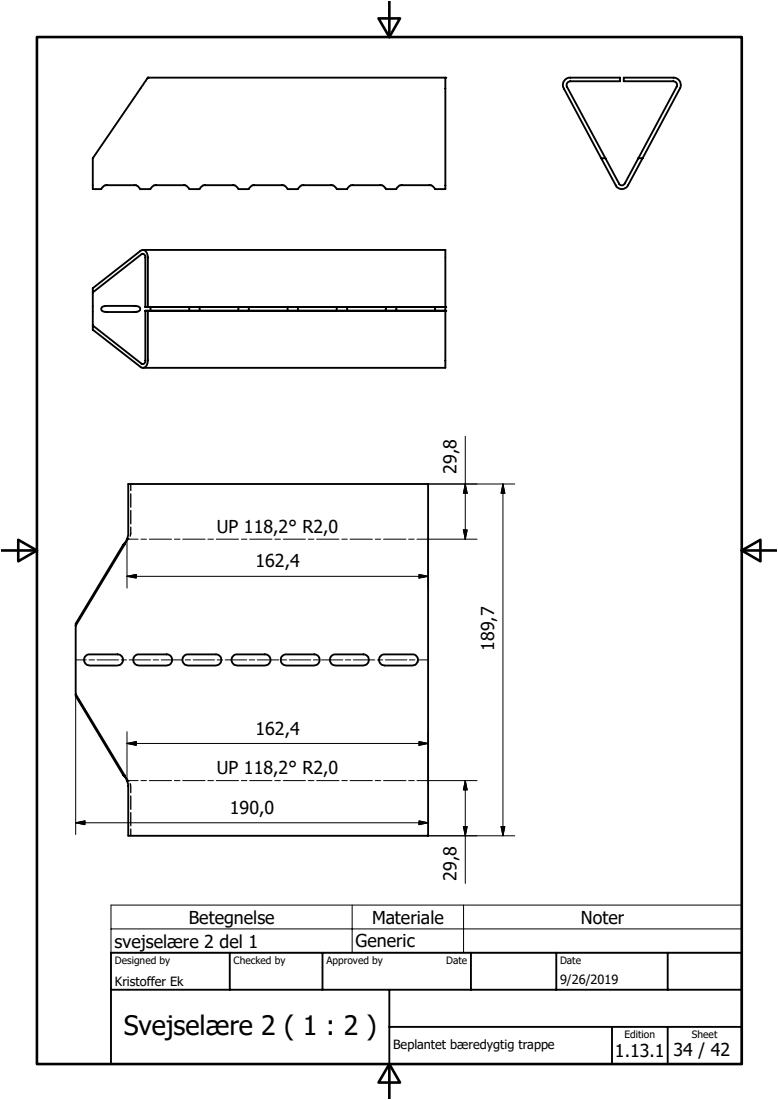
[picture p76: page 34]
Svejselære 2 ( 1 : 2 ); Beplantet bæredygtig trappe; Betegnelse; Materiale; Noter

svejselære 2 del 1 | Generic
Designed by Kristoffer Ek | Checked by | Approved by Date | Date 9/26/2019

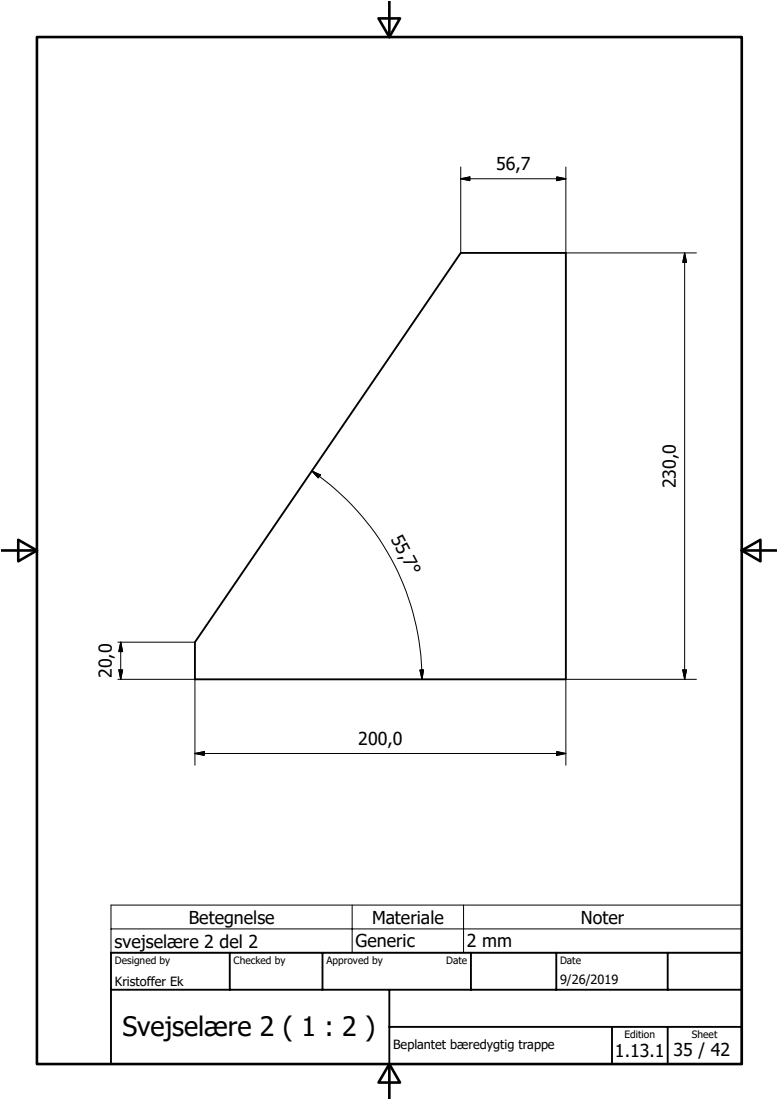
[picture p77: page 35]
Svejselære 2 ( 1 : 2 ); Beplantet bæredygtig trappe; Betegnelse; Materiale; Noter

svejselære 2 del 2 | Generic | 2 mm
Designed by Kristoffer Ek | Checked by | Approved by Date | Date 9/26/2019

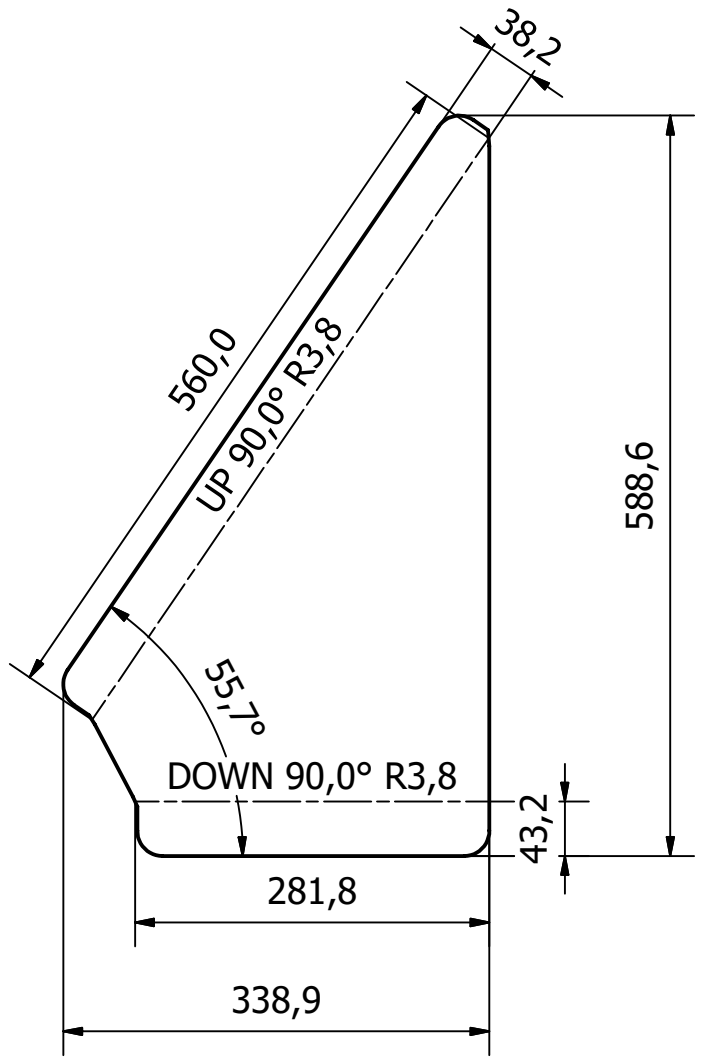
[picture p78: page 36]
Svejselære 3 ( 1:6 ); Beplantet bæredygtig trappe; Betegnelse; Materiale; Noter; DOWN 90,0° R3,8

svejselære 3 | Generic | 3 mm plade
Designed by Kristoffer Ek | Checked by | Approved by Date | Date 9/26/2019

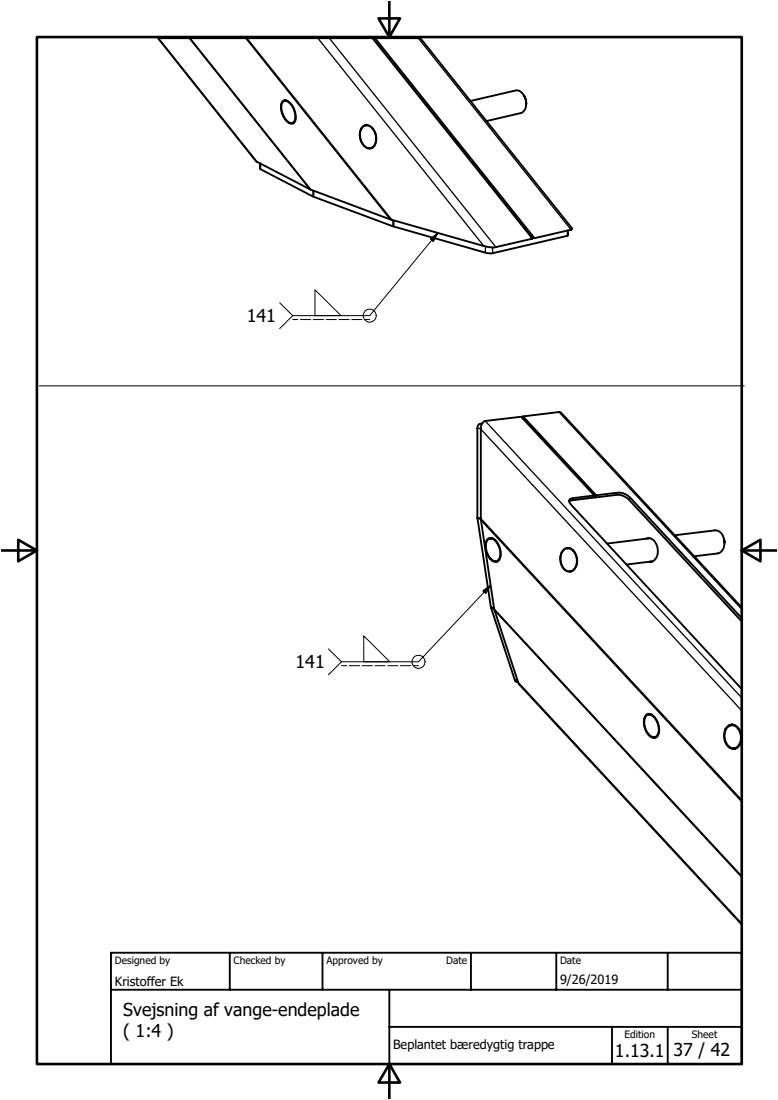
[picture p79: page 37]

Designed by Kristoffer Ek | Checked by | Approved by Date | Date 9/26/2019

Svejsning af vange-endeplade ( 1:4 )
Beplantet bæredygtig trappe

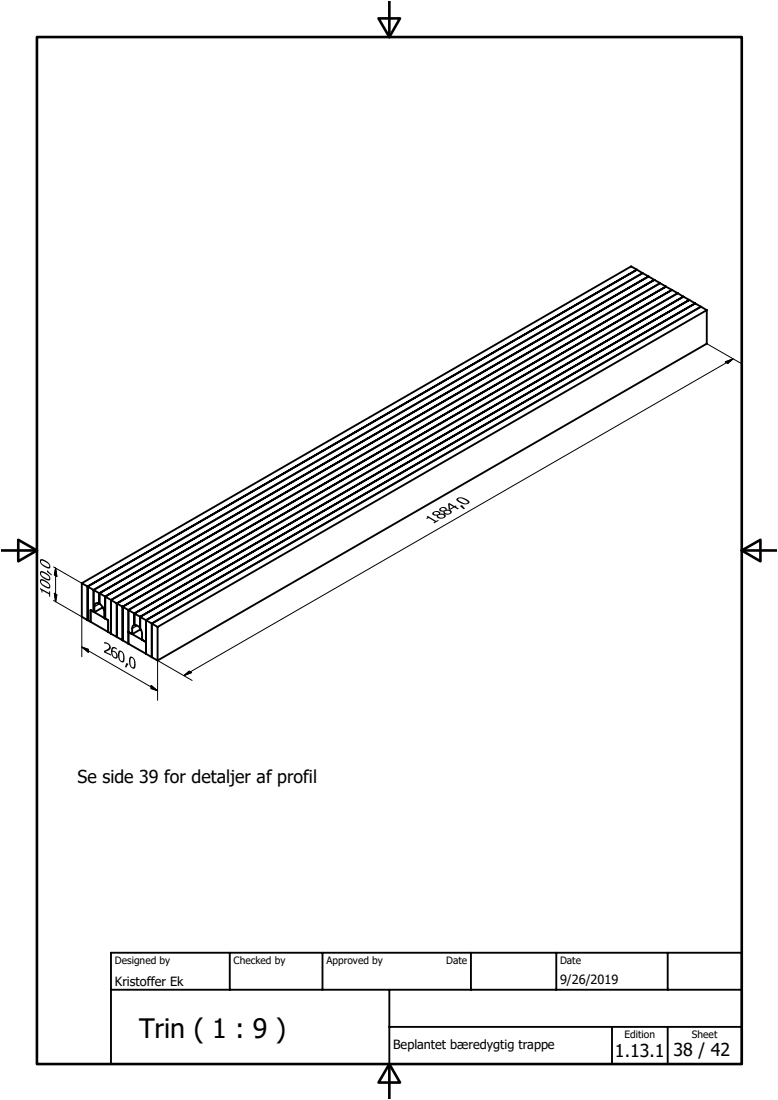
[picture p80: page 38]
Trin ( 1 : 9 ); Beplantet bæredygtig trappe; Kristoffer Ek; Designed by; Checked by; Approved by; Date

Se side 39 for detaljer af profil

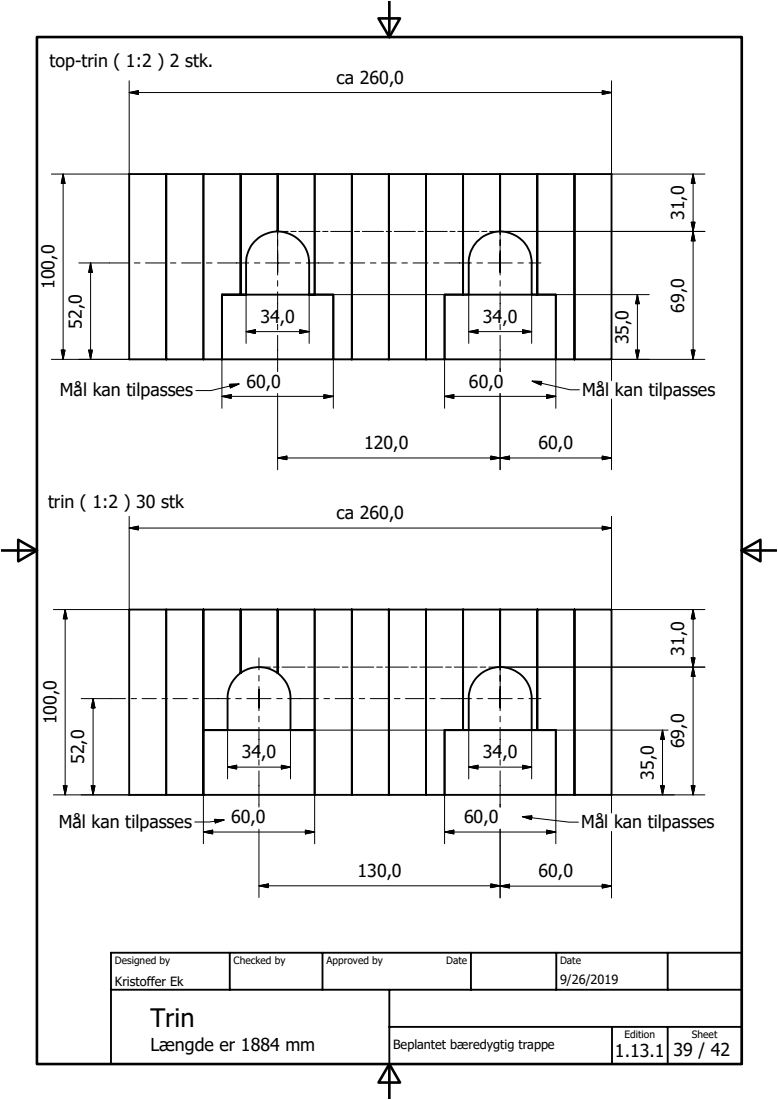
[picture p81: page 39]
trin ( 1:2 ) 30 stk

top-trin ( 1:2 ) 2 stk.

Mål kan tilpasses

Designed by Kristoffer Ek | Checked by | Approved by Date | Date 9/26/2019
Trin Længde er 1884 mm

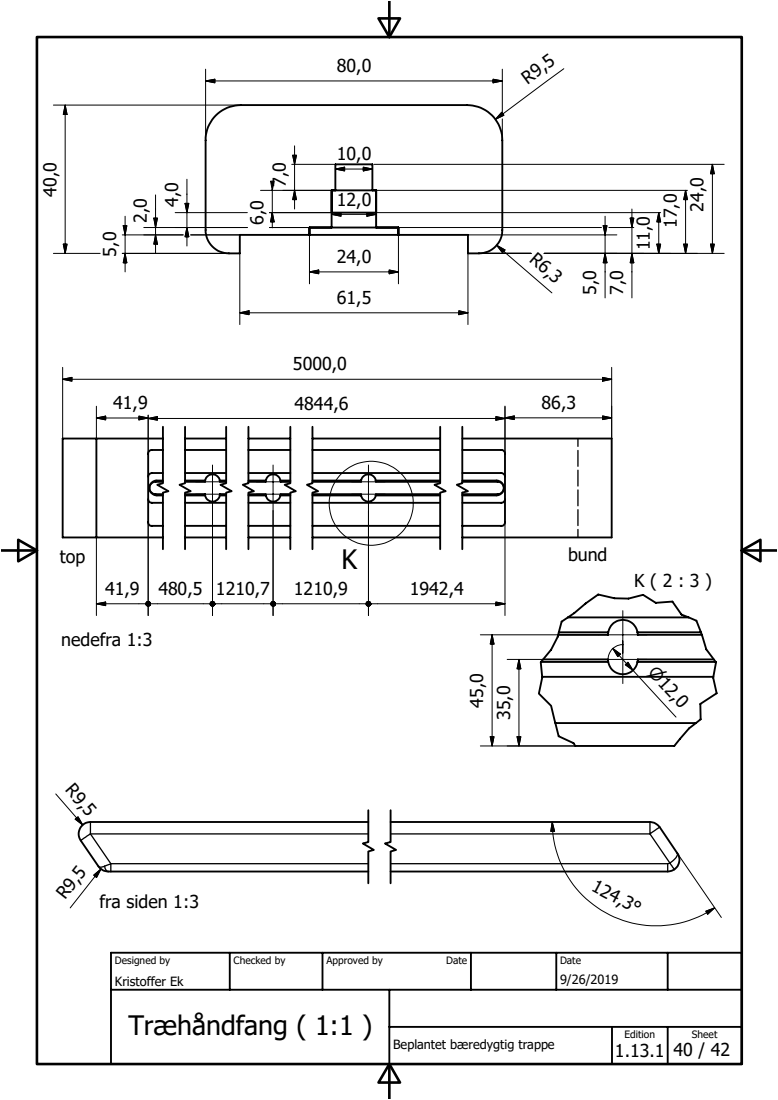
[picture p82: page 40]
nedefra 1:3; fra siden 1:3; Træhåndfang ( 1:1 ); Beplantet bæredygtig trappe; Kristoffer Ek; Designed by; Checked by; Approved by; Date; top; bund

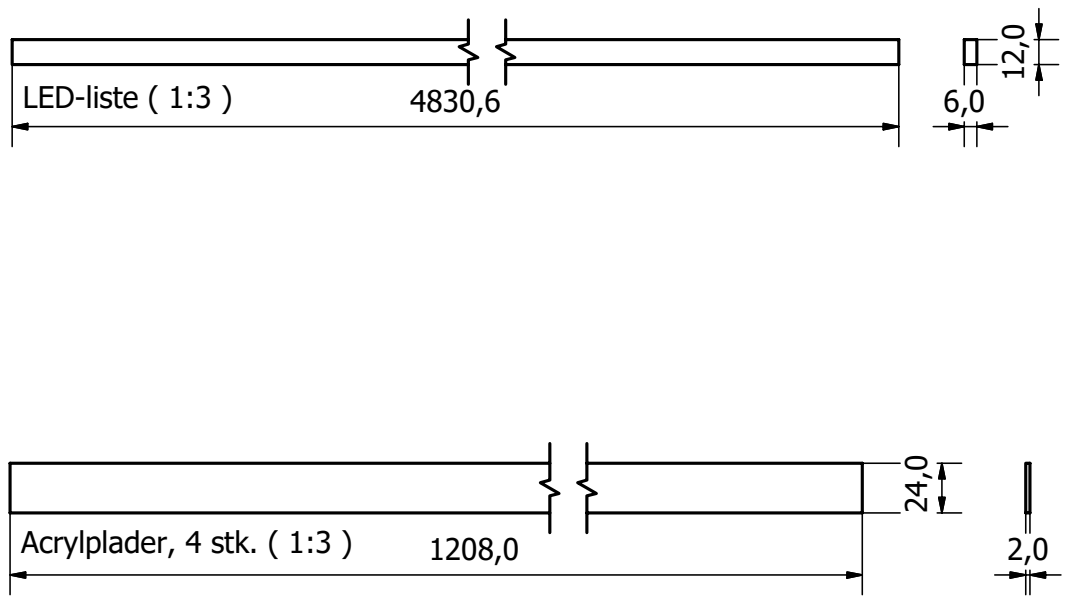
[picture p83: page 41]
LED-liste ( 1:3 ); Acrylplader, 4 stk. ( 1:3 ); Kristoffer Ek; Designed by; Checked by; Approved by; Date

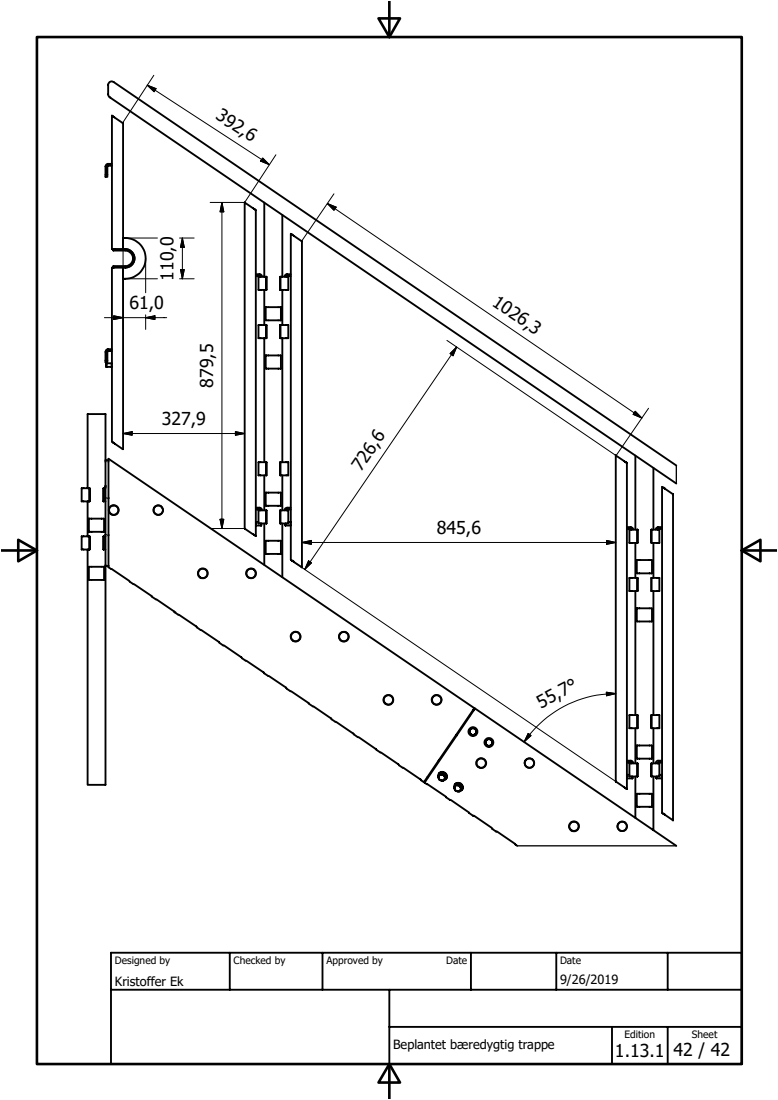
[picture p84: page 42]
Kristoffer Ek; Designed by; Checked by; Approved by; Date
