st0ff3r/trappe/skilt_outline.pdf

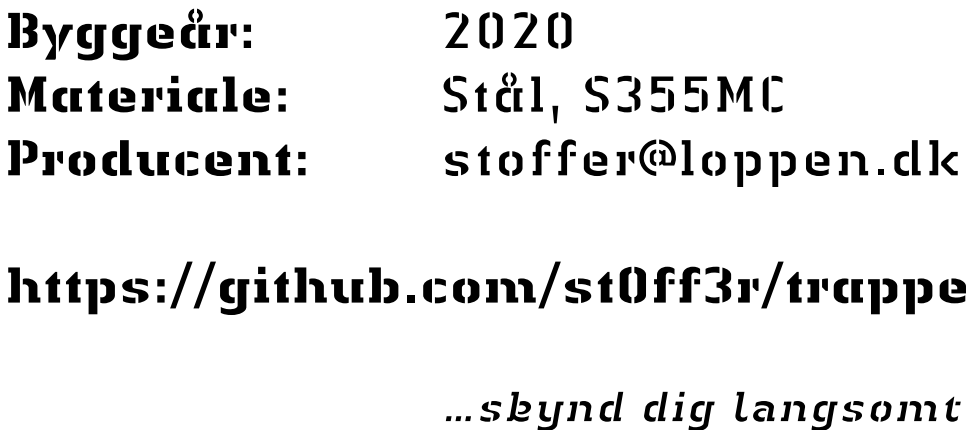
[picture p85: page 1]
