st0ff3r/trappe/dot.dk/Modul med baluster.pdf

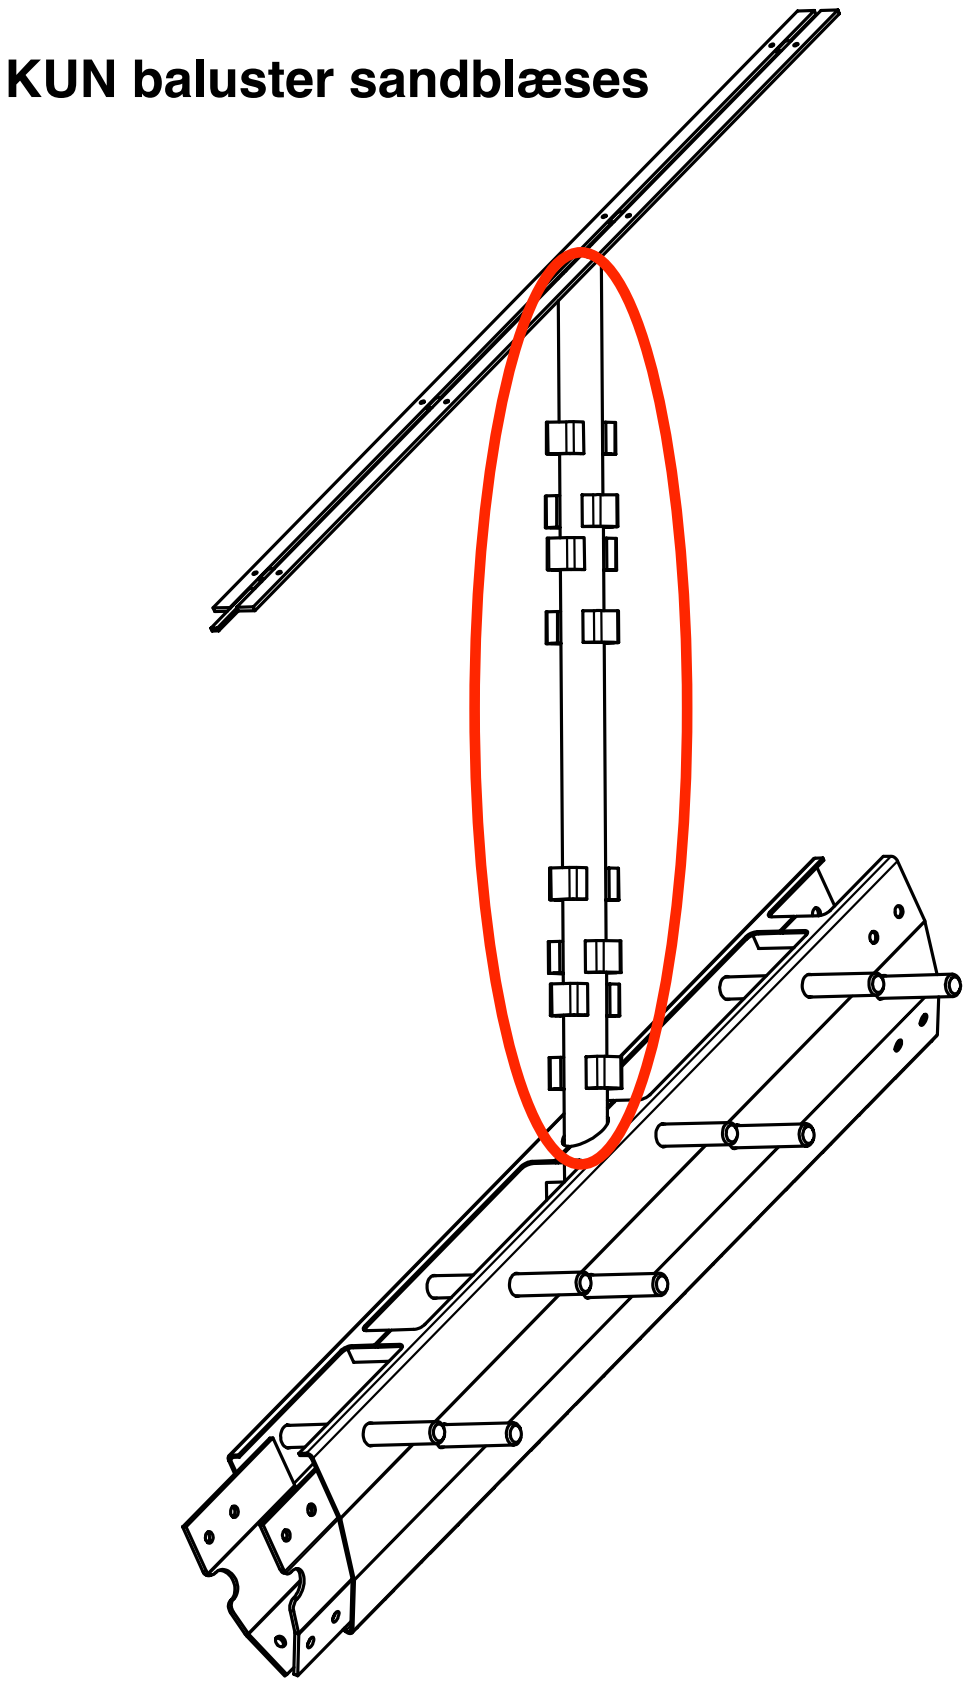
[picture p86: page 1]
