st0ff3r/trappe/(commit log)

2020-08-13 Afleveret svendeprøve
    [Bolted Connection1.iam, Bolted Connection10.iam, Bolted Connection11.iam, Bolted Connection12.iam, Bolted Connection13.iam, Bolted Connection14.iam, Bolted Connection15.iam, Bolted Connection16.iam]
2020-08-13 hegnspæl: udskæring for søjlesamling
    [bue.ipt, hegnspæl, oppe, top.0005.iam, hegnspæl, oppe, top.0006.iam, hegnspæl, oppe, top.iam]
2020-08-13 buet hegnspæl til platform
    [baluster-fod.0021.ipt, baluster-fod.0022.ipt, baluster-fod.ipt, bukket del.0003.ipt, bukket del.ipt, hegnspæl omvendt.0018.iam, hegnspæl omvendt.0019.iam, hegnspæl omvendt.iam]
2020-08-13 flere mål på buet hegnspæl
    [bue.0001.ipt, bue.ipt, bukket del.0003.ipt, bukket del.0004.ipt, bukket del.ipt, trappe.0204.idw, trappe.0209.idw, trappe.idw]
2020-08-18 med bukkede hegnspæle til platform
    [baluster-fod.0022.ipt, baluster-fod.0023.ipt, baluster-fod.ipt, bue.0001.ipt, bue.0003.ipt, bue.ipt, bukket del.0004.ipt, bukket del.0005.ipt]
2020-08-20 hager på hegnspæle opdaterede
    [hage.0004.ipt, hage.0005.ipt, hage.ipt, hegnspæl omvendt.0020.iam, hegnspæl omvendt.0021.iam, hegnspæl omvendt.iam, hegnspæl, oppe, top.0012.iam, hegnspæl, oppe, top.0014.iam]
2020-08-20 lås/gevindmuffer tilføjede
    [gevindmuffe.ipt, hegnspæl omvendt.0021.iam, hegnspæl omvendt.0028.iam, hegnspæl omvendt.iam, hegnspæl, oppe, top.0014.iam, hegnspæl, oppe, top.0016.iam, hegnspæl, oppe, top.iam, hegnspæl.0031.iam]
2020-10-16 kundefølgesedel + detaljer omkring trin
    [modul med balustre til dot.dk.dwg, trappe.0227.idw, trappe.0228.idw, trappe.idw, trin.0009.iam, trin.0010.iam, trin.iam, trinbrædt.0003.ipt]
2021-01-11 trin som sendt til snedker
    [baluster-fod.0025.ipt, baluster-fod.ipt, laske spejlet.0030.ipt, laske spejlet.ipt, laske.0037.ipt, laske.ipt, modul bund.0014.ipn, modul bund.0148.iam]
2021-09-24 håndfang med LED
    tegning af fræsninger til LED strip
    [hage.0003.ipt, hegnspæl omvendt.0028.iam, hegnspæl omvendt.0029.iam, hegnspæl omvendt.0030.iam, hegnspæl omvendt.iam, hegnspæl, oppe, top.0016.iam, hegnspæl, oppe, top.0017.iam, hegnspæl, oppe, top.0018.iam]
2021-09-25 håndfang tættere på søjle
    [modul bund.0155.iam, modul bund.0158.iam, modul bund.iam, modul.0183.iam, modul.0184.iam, modul.iam, søjle+vange.0036.ipn, søjle+vange.0037.ipn]
2021-09-30 acrylplader i håndfang
    [acryl-difuseringsplader.ipt, modul bund.0158.iam, modul bund.0161.iam, modul bund.iam, modul.0184.iam, modul.0186.iam, modul.iam, søjle+vange.0037.ipn]
2021-09-30 tydeligere tegning af fræsninger i håndfang
    [acryl-difuseringsplader.0001.ipt, acryl-difuseringsplader.ipt, håndfang snit.0006.iam, håndfang snit.iam, søjle+vange.0038.ipn, søjle+vange.0040.ipn, søjle+vange.0237.iam, søjle+vange.0244.iam]
2021-09-30 opdateret version
    [håndfang snit.0006.iam, håndfang snit.0007.iam, håndfang snit.iam, modul bund.0161.iam, modul bund.0162.iam, modul bund.iam, søjle+vange.0040.ipn, søjle+vange.0041.ipn]
2021-09-30 tyndere led-liste (6mm)
    [håndfang snit.0007.iam, håndfang snit.0008.iam, håndfang snit.iam, led-liste.0001.ipt, led-liste.0002.ipt, led-liste.ipt, modul bund.0162.iam, modul bund.0163.iam]
2021-11-11 updated content center files
    [Bolted Connection1.iam, Bolted Connection10.iam, Bolted Connection11.iam, Bolted Connection12.iam, Bolted Connection13.iam, Bolted Connection14.iam, Bolted Connection15.iam, Bolted Connection16.iam]
2022-05-25 dimensioner på hegn
    [armeringsjern.0001.ipt, armeringsjern.0002.ipt, armeringsjern.ipt, hage.0002.ipt, hage.0003.ipt, hage.ipt, liste.0001.ipt, liste.ipt]
